thurnertristan/diplomarbeit_dateien/Mechanik/Gesamtprojekt Biegelehre/Biegelehre (Gesamtpr.)/20260723_121837 (1).jpg

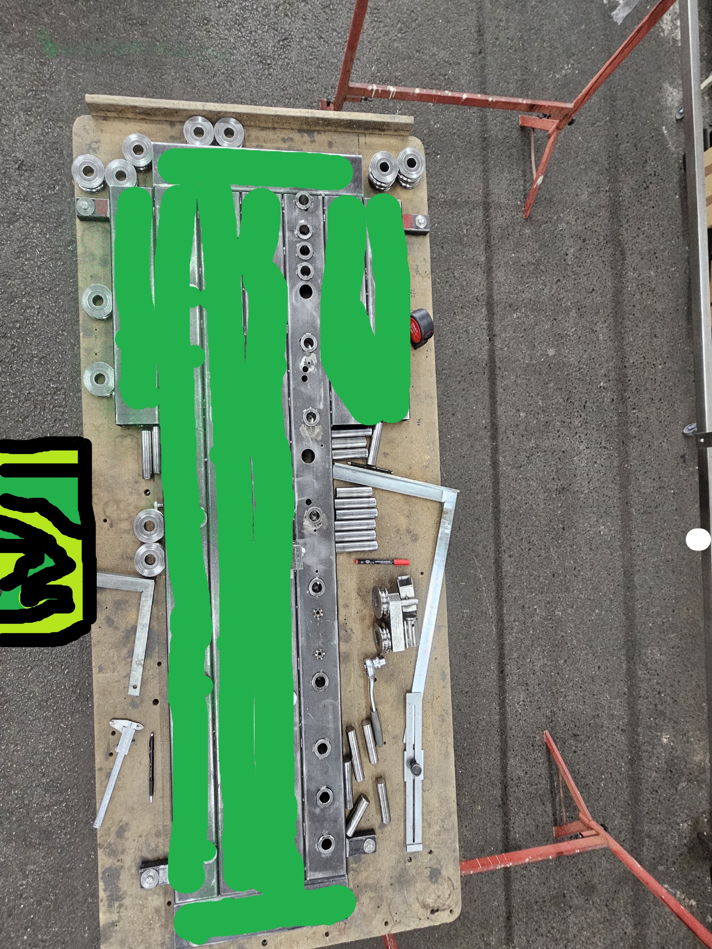
Mechanik/Gesamtprojekt Biegelehre/Biegelehre (Gesamtpr.)/20260723_121837 (1).jpg
