thurnertristan/diplomarbeit_dateien/Dokumentation Ferialpraktikum.docx

# Dokumentation Ferialpraktikum

## 1. Ausgangslage

Die Firma Dry Expert SMD fertigt Trocknungsanlagen, dafür brauchen sie 2D Gestelle aus Edelstahlrohre in verschiedenen Formen. Diese werden zurzeit händisch gebogen: Eine Person spannt Rohr ein, setzt Biegerollen an den passenden Positionen in einer Lochraster Biegelehre ein und biegt anschließend mit einer Verlängerung das Rohr um die Rollen. Dieser Prozess ist auf Dauer körperlich sehr anspruchsvoll und benötigt Erfahrung.

Ziel der Diplomarbeit ist die Automatisierung des Biegevorgangs mit einem an der Decke montierten Roboterarm. Der Roboterarm platziert die Rollen selbstständig auf der Biegelehre und führt danach mit einem selbst konstruierten Biegekopf die Biegung aus. Die gewünschte Form wird über einen Touchscreen ausgewählt. Es wurde sich bewusst für die Deckenmontage entschieden, da so der Arbeitsbereich kleiner ist und das Einlegen des Rohres weiterhin leicht möglich ist.

Das Rohr hat einen Außendurchmesser von 14mm, eine Wandstärke von 1mm und besteht aus Edelstahl 1.4404 (316).

## 2. Aufgabenteilung

Sebastian Benedikt: Auswahl elektrischer Bauteile, Verkabelung, Auslegung der Elektronik sowie Programmierung der Steuerung und des Roboterarms.

Tristan Thurner: Gehäuse für Elektronik, Sicherheitsbewertung, Biegekopf Konstruktion, Berechnungen für Auswahl sämtlicher mechanischen Komponenten

## 3. Technisches Gesamtkonzept

Das System besteht aus einem an der Decke montierten Fairino FR20 Roboterarm, der zwei Aufgaben in einem Arbeitszyklus übernimmt: Erstens das einsetzen der Stifte und Biegerollen in die Schablone, zweitens das eigentliche Biegen des Rohres mit einem eigens entwickelten, motorisierten Biegekopf (Servomotor & Planetengetriebe). Die Umschaltung zwischen den beiden Werkzeugen erfolgt über einen automatischen Werkzeugwechsler (ATC).

Durch den Biegekopf muss nicht der Fairino Cobot die ganze Kraft der Biegung aufwenden sondern muss nur noch die Haltekraft, da der Servomotor die Kraft aufwendet.

### Kinematik des Biegekopfs

Der Biegekopf dockt über eine Kugellagerbohrung auf den Bolzen der feststehenden Rolle an. Bildet den ortsfesten nicht rotierenden Drehpunkt, koaxial zur Antriebswelle. Ein Schwenkarm, der einen fest montierten zweiten Bolzen mit einer nadelgelagerten Rolle trägt, rotiert um diesen Drehpunkt und reproduziert damit exakt die Bewegung der Bisherigen manuellen Biegevorrichtung. Motor und Getriebe im Gehäuse des Biegekopfs bleiben ortsfest, nur die Antriebswelle treibt den Schwenkarm an. Das geschätzte Gesamtgewicht des Biegekopfs inkl. ATC liegen bei rund 17,5kg.

## 4. Auswahl und Auslegung der elektronischen Komponenten

Im Rahmen des Praktikums wurde eine komplette Elektronik-Stückliste (BOM) erarbeitet und dokumentiert. Alle zehn Kategorien – Antrieb, Recheneinheit, MCU, HMI, Werkzeugwechsler, Kommunikation, Sicherheitstechnik, Stromversorgung, Sensorik und Schaltschrank – sind mittlerweile weitestgehend final entscheiden. Die folgenden Tabellen fassen die wichtigsten Entscheidungen zusammen.

### Antriebsstrang

Komponente | Auswahl | Kernspezifikation | Preis (netto) | Status
Roboterarm | Fairino FR20 | 20 kg Traglast, 1854 mm Reichweite, ±0,1 mm, CE/ISO 10218 | 14.678,00 € | Final
Motor Biegekopf | Panasonic Minas A6 MSMF082L1U1 | 750 W, 2,39 Nm nominal / 7,16 Nm Spitze, 23-Bit-Encoder | 557,95 € | Final
Getriebe Biegekopf | APEX AB115-S2-P2, i=100 | ~225 Nm Dauermoment (nach Wirkungsgrad), gebraucht, 10–12 kg | 479,80 €* | Final (Fallback eBay)
Servoverstärker | Panasonic MCDLN35SE | B-Frame, 750 W, 230 VAC, passend zu MSMF082L1U1 | 1.223,04 € | Final

### Steuerung, HMI & Werkzeugwechsler

Komponente | Auswahl | Kernspezifikation | Preis (netto) | Status
Recheneinheit | Beelink Mini S12 Pro | Intel N100, 16 GB RAM, 500 GB SSD, Ubuntu 24.04 LTS + ROS2 Jazzy | 369,00 € | Final
MCU Biegekopf | STM32 Nucleo-F401RE | ARM Cortex-M4, lokale PWM-/Encoder-Ansteuerung im Biegekopf | ~20,00 € | Final
Touchscreen | Elecrow RC070 | 7" IPS, 1024×600, kapazitiv, USB + HDMI | ~53,00 € | Final
Werkzeugwechsler (ATC) | Schunk SWS-I/SWS-L + SWO-E | Elektromodul für RS485-Durchführung; SWK am Roboter, SWA je Werkzeug | 3.000–7.000 €* | Final (Angebot ausständig)

### Sicherheitstechnik und Stromversorgung

Komponente | Auswahl | Kernspezifikation | Preis (netto) | Status
Sicherheitslichtgitter | Pilz PSENopt | Typ 4 / PL e, Schutzfeldhöhe noch offen (Platzhalter 500 mm) | ~350,00 € | Final*
Sicherheitsrelais | Pilz PNOZ X1 | 24 V AC/DC, Kat. 4 / PL e, für Not-Aus + Lichtgitter | ~75,00 € | Final
Not-Aus-Taster | Pilz PIT es Set1s-5 | 2 Öffner, IP65, mechanische Entriegelung | ~60,00 € | Final
24V-Netzteil | Mean Well NDR-240-24 | 24 V DC, 240 W, 10 A, Hutschienenmontage | ~80,00 € | Final
DC-DC-Wandler | Mean Well SD-25B-12 | 24 V → 12 V, versorgt Mini-PC; wird vom Not-Aus mit abgeschaltet | ~35,00 € | Final

### Kommunikation, Sensorik und Gehäuse

Komponente | Auswahl | Kernspezifikation | Preis (netto) | Status
RS485-Modul (STM32-Seite) | MAX485 TTL-zu-RS485 | Im Biegekopf, Anschluss über Schraubklemmen A/B/GND | ~8,00 € | Final
USB-RS485-Konverter (PC-Seite) | Delock 62501 | 3 kV galvanisch isoliert, DIN-Schienenmontage | ~38,00 € | Final
Näherungssensor Werkzeugwechsel | Schunk IN-Serie (z. B. IN 40/S-M8) | 24 V DC, induktiv, Rückmeldung „Kopf angedockt“ | ~70,00 € | Final
Schaltschrank | Stahlblech-Wandgehäuse 800×600×300 | IP66, Leistungs-/Steuerzone nach EN 60204-1 getrennt | ~180,00 € | Final*

## 5. Softwareentwicklung (ROS2 – Workspace)

Parallel zur elektrischen Auslegung wurde bereits mit der Softwareentwicklung begonnen, um Zeit bis zum Eintreffen der Roboterhardware sinnvoll zu nutzen. Bereits programmiert wurde die Grundstruktur des Projekts. Außerdem wurde eine erste Simulation in Gazebo programmiert welche man mit einer GUI steuern kann welche wir mit Pygubu designed haben. Es wurden schon erste Testprogramme programmiert bei denen der Roboterarm bestimmte Punkte anfahren kann. Jedoch können wir die eigentlichen Programme erst richtig realisieren wenn wir die Hardware bekommen. Jedes Programm ist eigentlich nur eine JSON Datei in der die Punkte definiert werden und ein Python Programm rechnet sich dann die Bewegungen aus. Somit kann man neue Programme leicht erstellen und braucht nur einmal die Grundstruktur.

## 6. Mechanische Konstruktion

Es wurde bereits die erste Version des Biegekopfs konstruiert dieser beinhaltet das Gehäuse des Motors und Getriebe, Deckel mit flansch für ATC, der Verlängerung am Getriebe mit Kugellager und Stift. Außerdem wurde die Deckenkonstruktion konstruiert wo der Roboterarm in weiterer folge befestigt wird.

## 7. Nächste Schritte

- Berechnung aller relevanten Daten für den Biegekopf, Deckenmontage usw.
- Bestellung aller Teile und Fertigung des Biegekopfes
- Programmierung erweitern und verbessern
- Sicherheitskonzept ausarbeiten und finalisieren
