thurnertristan/diplomarbeit_dateien/Arbeitszusammenfassung.docx

# Arbeitszusammenfassung:

3.8.: schwächerer Cobot z.B. ur10 Biegung mit modularen Drehkopf Endeffektor mit eigenem Motor damit Roboterarm nicht Kraft aufwenden muss sondern nur halten und eigener Motor biegt. Mit Servomotor Planetengetriebe und Kupplung. Aufbau eigentlich gleich wie jetzt gerade nur nicht händisch drehen sondern mit dem Drehkopf.
