thurnertristan/diplomarbeit_dateien/Elektronik/Verkabelungskonzept_Rohrbiegesystem.docx

Diplomarbeit · Automatisiertes Rohrbiegesystem

Verkabelungskonzept – Elektronik

Stand: 19.08.2026 · Sebastian Benedikt / Tristan Thurner · für Dry Expert SMD GmbH

# 1. Überblick

Das Verkabelungskonzept beschreibt, wie Steuerung, Antrieb, Kommunikation und Sicherheitstechnik des Rohrbiegesystems miteinander verdrahtet werden. Die Elektronik ist auf einen zentralen Schaltschrank, den deckenmontierten Roboterarm (Fairino FR20) und den wechselbaren Biegekopf verteilt. Kernpunkt ist der Kabelweg vom Schaltschrank über den Roboterarm bis zum Motor im Biegekopf – dieser muss den automatischen Werkzeugwechsel (ATC) durchqueren, ohne dass beim Wechseln Kabel getrennt oder gesteckt werden müssen.

Der Schaltschrank gliedert sich nach EN 60204-1 in eine Steuerzone (Kleinspannung, Kommunikation) und eine Leistungszone (230 V AC, Servoantrieb), dazu kommt eine separate Sicherheitskette (Not-Aus, Lichtgitter, Sicherheitsrelais). Alle drei Zonen sind im Schaltschrank räumlich getrennt untergebracht.

# 2. Schaltschrank – Steuerzone

In der Steuerzone sitzen alle kleinspannungsseitigen Komponenten der Recheneinheit und Kommunikation:

- Mini-PC Beelink Mini S12 Pro – Recheneinheit für ROS2/MoveIt2, PANATERM und die Bedien-GUI
- Touchscreen Elecrow RC070 (7") – an den Mini-PC über HDMI + USB angebunden, sitzt auf der Schranktür
- DC-DC-Wandler Mean Well SD-25B-12 – wandelt 24 V DC auf 12 V DC für die Stromversorgung des Mini-PCs; dadurch schaltet der zentrale Not-Aus auch den PC mit ab
- USB-RS485-Konverter Delock 62501 – galvanisch isoliert (3 kV), verbindet den Mini-PC per internem USB mit dem RS485-Bus

Die galvanische Isolierung des RS485-Konverters ist notwendig, weil die RS485-Leitung im weiteren Verlauf direkt neben dem Servoverstärker liegt, der mit bis zu 22 A und steilen PWM-Flanken schaltet. Ohne Trennung könnten Störungen bis zum USB-Port des Mini-PCs durchschlagen.

# 3. Schaltschrank – Leistungszone

Die Leistungszone enthält die 230-V- und 24-V-Versorgung sowie den Servoantrieb:

- 24V-Netzteil Mean Well NDR-240-24 (240 W, 10 A, Hutschiene) – zentrale Kleinspannungsversorgung für STM32, RS485-Modul, Sicherheitsrelais und DC-DC-Wandler
- LS-Schalter 10 A + 230-VAC-Zuleitung – Netzeinspeisung für den Servoverstärker
- Servoverstärker Panasonic MCDLN35SG – erhält 230 V AC Leistungseinspeisung sowie den Freigabekontakt aus der Sicherheitskette; kommuniziert per Modbus-RTU über RS485

Der Servoverstärker bleibt fest im Schaltschrank montiert – nur der Motor sitzt im wechselbaren Biegekopf. Das ist bewusst so gewählt, damit beim Werkzeugwechsel kein Leistungsteil mitbewegt werden muss.

# 4. Sicherheitskette

Die Sicherheitskette ist als eigener, elektrisch unabhängiger Strang nach Kategorie 4 / PL e aufgebaut:

- Sicherheitslichtgitter Pilz PSENopt (Typ 4, PL e) → OSSD-Sicherheitssignal an das Sicherheitsrelais
- Not-Aus-Taster Pilz PIT es Set1s-5 → 2 Öffner-Kontakte an das Sicherheitsrelais
- Sicherheitsrelais Pilz PNOZ X1 (24 V AC/DC, Kat. 4 / PL e) → gibt bei „alles frei" den Freigabekontakt für die Motorleistung am Servoverstärker frei

Lichtgitter und Not-Aus-Taster wirken damit gemeinsam auf denselben Freigabepfad: Erst wenn beide Bedingungen erfüllt sind, schaltet das PNOZ X1 den Servoverstärker frei. Die Schutzfeldhöhe des Lichtgitters ist aktuell ein Platzhalter (500 mm) und wird nach der ISO-12100-Beurteilung final festgelegt.

# 5. Kabelweg durch den Werkzeugwechsler (ATC)

Der automatische Werkzeugwechsler (Schunk SWS-I/SWS-L mit SWO-E-Elektromodul) ist die kritischste Stelle im Verkabelungskonzept, weil hier Leistungs- und Signalkabel ohne manuellen Steckvorgang durchgeführt werden müssen.

- Vom Schaltschrank laufen Motorkabel (U/V/W + Encoder) und die isolierte RS485-Leitung über eine Kabelführung am Roboterarm zur roboterseitigen ATC-Hälfte (SWK).
- Die SWO-E-Durchführung überträgt die Signale per federbelasteten, goldbeschichteten Kontaktstiften automatisch beim mechanischen Andocken – kein separater Steckvorgang nötig.
- Werkzeugseitig (SWA) werden die Leitungen wieder aufgeteilt und laufen kurz weiter zu Motor, RS485-Modul (MAX485) und STM32 im Biegekopf.
- Zusätzlich liefert die Kolbenhubabfrage-Option am SWK mit einem Schunk-eigenen Näherungssensor das digitale 24-V-Signal „Kopf angedockt" zurück an den STM32.

Offen ist noch, ob ein gemischtes SWO-E-Modul (Signal + Leistung) für die 22-A-Motorphasen ausreicht oder ob Schunk getrennte Module für Signal und Leistung vorschreibt. Beide Varianten würden aber an derselben SWK/SWA-Kupplungsstelle sitzen – es entsteht keine zweite ATC-Schnittstelle.

# 6. Motor-, Encoder- und Batteriekabel

Für die Strecke Schaltschrank → Roboterarm → ATC → Biegekopf wurden die Original-Panasonic-Kabel in 10 m Länge gewählt (Motorkabel MFMCA0100NJD, Encoderkabel MFECA0100MJE):

- Die Kabel sind werksseitig mit Steckern an beiden Enden konfektioniert und müssen daher in der Mitte durchtrennt werden, um durch die ATC-Trennstelle geführt zu werden.
- Beide neu geschnittenen Enden erhalten je einen Steckverbinder auf SWK bzw. SWA – die Original-Werksstecker bleiben an den jeweiligen Kabelenden erhalten.
- Kritisch: Die Encoder-Batteriebox (DV0P2990) für die Multiturn-Absolutfunktion muss auf der motorseitigen Kabelhälfte sitzen. Sonst verliert der Encoder bei jedem Werkzeugwechsel seine Absolutposition, weil die Batterieverbindung beim Abkoppeln unterbrochen wird.
- Der Anschluss am Servoverstärker (MCDLN35SG) erfolgt über die Panasonic-Steckverbinder DV0PM20032 (XA, Netzanschluss) und DV0PM20034 (XB, Motoranschluss) – der Verstärker selbst hat keine festen Klemmen.

Das eigentliche Zuschneiden der Kabel erfolgt erst, sobald das Schunk-Angebot mit der finalen RS485-Pinbelegung und Kontakt-Terminierungsart vorliegt.

# 7. Kommunikationskette (RS485)

Die Ansteuerung von Servoverstärker und STM32 läuft über eine gemeinsame, durchgeschleifte RS485-Leitung:

- Mini-PC → Delock 62501 (isolierter USB-RS485-Konverter) → RS485 A/B/GND durch die SWO-E-Durchführung → MAX485-Modul im Biegekopf → STM32 Nucleo-F401RE
- Der STM32 steuert darüber hinaus den Servoverstärker direkt über ein Pulszug-/Step-Dir-Signal, das ebenfalls durch die ATC-Durchführung geführt wird.
- Die RS485-Pinbelegung ist noch eine vorläufige Annahme und wird gegen das konkrete Schunk-SWO-E-Angebot verifiziert (siehe „RS485_Leitungsplanung_SWO-E.docx").

# 8. Robotersteuerung

Die FR20-Robotersteuerung (Controller-Box) ist als separate Einheit vom Mini-PC über Ethernet (TCP/IP) angebunden und steuert von dort aus die sechs Achsen (J1–J6) des Roboterarms. Diese Schnittstelle ist bislang softwareseitig noch nicht endgültig geprüft und bleibt ein offener Punkt. Die Maße der FR20-Controller-Box müssen zudem bei Inlux Robotics angefragt werden, um zu klären, ob sie in den geplanten Schaltschrank passt.

# 9. Energiekette am Roboterarm

Für die flexible Kabelführung entlang der Roboterarm-Bewegung ist eine 3D-Zugkette speziell für die FR20 vorgesehen (3 m Länge, 37 mm Innenkanal, 4 Schraubhalterungen für die vorhandenen Befestigungslöcher am Arm, seitlich zu öffnen), erhältlich bei TMC Robotics. Eine interne Kabeldurchführung durch die FR20 selbst gibt es nicht – die Kabelführung verläuft komplett extern am Arm entlang, wie bei diesem Robotermodell üblich.

# 10. Übersichtstabelle Hauptverbindungen

Von | Nach | Leitung / Signal
Mini-PC | Touchscreen | HDMI + USB
Mini-PC | USB-RS485-Konverter | USB (intern, Host)
24V-Netzteil | DC-DC-Wandler → Mini-PC | 24 V DC → 12 V DC, Hohlstecker
24V-Netzteil | Sicherheitsrelais / ATC / STM32 | 24 V DC Versorgung
LS-Schalter | Servoverstärker | 230 V AC Leistungseinspeisung
Lichtgitter | Sicherheitsrelais | OSSD-Sicherheitssignal
Not-Aus-Taster | Sicherheitsrelais | 2× Öffner-Kontakt
Sicherheitsrelais | Servoverstärker | Freigabekontakt (Motorleistung)
USB-RS485-Konverter | ATC-Durchführung | RS485 A/B/GND, isoliert 3 kV
Servoverstärker | ATC-Durchführung | Motorkabel: U/V/W + Encoder
ATC-Durchführung | Motor (Biegekopf) | Motorkabel: U/V/W + Encoder
ATC-Durchführung | RS485-Modul (MAX485) | RS485 durchgeschleift
RS485-Modul | STM32 | UART (TTL)
STM32 | Servoverstärker | Pulszug/Step-Dir-Signal (durch ATC)
Näherungssensor | STM32 | digitales 24-V-Signal (Kopf angedockt)
Mini-PC | FR20-Robotersteuerung | Ethernet TCP/IP (offener Punkt)
FR20-Robotersteuerung | Roboterarm FR20 | Motion-Steuerung (Achsen J1–J6)

# 11. Offene Punkte

- RS485-Pinbelegung gegen das tatsächliche Schunk-SWO-E-Angebot prüfen.
- Klärung 1-vs-2-Module-Frage bei SWO-E: gemischtes Signal/Leistungs-Modul oder getrennte Module?
- Sicherungsdimensionierung der Servoverstärker-Zuleitung von einer Elektrofachkraft prüfen lassen.
- Ethernet-Anbindung Mini-PC ↔ FR20-Robotersteuerung softwareseitig verifizieren.
- 10-m-Kabel erst nach Vorliegen des Schunk-Angebots in der Mitte trennen und auf SWK/SWA terminieren (Batteriebox motorseitig).
- Maße der FR20-Robotersteuerung bei Inlux Robotics anfragen (Platzbedarf im Schaltschrank).
- Schutzfeldhöhe des Lichtgitters nach Tristans ISO-12100-Beurteilung final festlegen.

Quelle: Projekt-Dashboard „rohrbiegesystem_dashboard.html" und Verkabelungsdiagramm „Elektronik_Verkabelung_Rohrbiegesystem.drawio", Stand 19.08.2026.
