thurnertristan/diplomarbeit_dateien/Roboterauswahl/Roboterauswahl.docx

Roboterauswahl

Cobots:

Hersteller | Modell | Traglast | Preis | Link
DOOSAN | H2017 | 20kg | 20.400€ | https://www.maschinensucher.at/doosan-h2017/i-20891532
Universal Robots | UR10 | 10kg | 15.500€ | https://www.maschinensucher.at/cobot+universal+robots-ur10+cb3.1/i-22373017

Industrieroboter

Hersteller | Modell | Traglast | Preis | Link
KUKA | KR16 | 16kg | Auf Anfrage | https://www.maschinensucher.at/kuka-kr+16/i-22401477
KUKA | KR16 | 16kg | 8.500€ | https://www.maschinensucher.at/kuka-kr+16+l6-c/i-18950501
ABB | IRB4600-20/2.50 | 20kg | 11.500€ | https://www.maschinensucher.de/abb-irb4600-20%2F2.50/i-20652730
