thurnertristan/diplomarbeit_dateien/Servoverstaerker_Antriebsstrang_BOM.xlsx

Einkaufsliste: Servoverstärker-Antriebsstrang
# | Teil | Teilenummer | Zweck | Preis | Lieferzeit | Bezugsquelle | Link
1 | Servoverstärker | MCDLN35SG | Motoransteuerung (RS485/Modbus + Pulszug) | 829,54 € netto | Sofort (2 Stk. auf Lager) | DigiKey | https://www.digikey.at/en/products/detail/panasonic-industrial-automation-sales/MCDLN35SG/7354308
2 | Encoderkabel (Original) | MFECA0100MJE | 10m, Driver↔Motor Encoder (23-Bit Absolut) | 614,74 € netto | 1 Stk. auf Lager – bei Nachbestellung 36 Wochen | DigiKey | https://www.digikey.at/en/products/detail/panasonic-industry/MFECA0100MJE/3898448
3 | Motorkabel (Original) | MFMCA0100NJD | 10m, Driver↔Motor Leistung (U/V/W) | 539,26 € netto | 1 Stk. auf Lager – bei Nachbestellung 36 Wochen | DigiKey | https://www.digikey.at/en/products/detail/panasonic-industry/MFMCA0100NJD/3898493
4 | Netzanschluss-Stecker (XA) | DV0PM20032 | Steckverbinder für Netzzuleitung zum Driver | 37,07 € netto | ca. 4 Wochen | electricautomationnetwork.com | https://www.electricautomationnetwork.com/en/panasonic/dv0pm20032-panasonic-minas-a5-driver-power-connector-xa-50w-to-15kw-1-row
5 | Motorstecker (XB) | DV0PM20034 | Steckverbinder für Motorkabel am Driver, inkl. Jumper-Kabel | 37,07 € netto | ca. 4 Wochen | electricautomationnetwork.com | https://www.electricautomationnetwork.com/en/panasonic/dv0pm20034-panasonic-connector-for-minas-a5-driver-motor-connection-xb-50w-15kw-spring-force-plug-spare
Summe (netto): |  |  |  | 2.057,68 € netto
