thurnertristan/diplomarbeit_dateien/Bestellliste_aktuelle_Runde_kompakt_4.xlsx

Bestellliste – Aktuelle Runde
Stand 21.08.2026 · Preise vor Bestellung erneut bestätigen
Komponente | Anbieter | Preis (EUR) | Link
Beelink Mini S12 Pro (Intel N100, 16 GB RAM, 500 GB SSD) | Amazon.de | 362.02 | https://www.amazon.de/Beelink-MINI-S12-Alder-Lake-N100-Processor/dp/B0B7WCTXMT
Elecrow DIS85101D, 10.1" IPS 1280x800, kapazitiver Touch, Acrylgehäuse | Elecrow (Direktshop, China) | 77.00 | https://www.elecrow.com/elecrow-10-1-inch-display-ips-1280x800-acrylic-case-touch-screen-compatible.html
Waveshare USB TO RS485/422, Industrial Grade Isolated Converter | Amazon.de | 30.24 | https://www.amazon.de/Waveshare-USB-RS485-422-Long-Distance/dp/B0BTBR71PC
Mean Well NDR-240-24 | DigiKey AT/DE | 47.39 | https://www.digikey.de/de/products/detail/mean-well-usa-inc/NDR-240-24/7705222
Mean Well SD-25B-12, geschlossene Bauform | DigiKey AT/DE | 22.29 | https://www.digikey.de/de/products/detail/mean-well-usa-inc/SD-25B-12/7706509
Panasonic DV0PM20024CAB020 (X2-Steckverbinder für Verstärker, RS485/RS232) | electricautomationnetwork.com | 49.16 | https://electricautomationnetwork.com/en/panasonic/dv0pm20024cab020-panasonic-communication-cable-rs232-rs485-for-minas-a5-x2-connector-8-pins-and-loose-threads
Summe |  | 588.10
