thurnertristan/diplomarbeit_dateien/Mechanik/Biegekopf/Gehaeuse_gesamt/Anzahl.xlsx

Bauteil Name | Anzahl
geheause_motor | 1
gehaeuse_getriebe | 1
BT022_thutrn22_26_Biegeroboter_gehaeuse_deckel_motor_v3 | 1
BT025_thutrn22_26_Biegeroboter_gehaeuse_deckel_getriebe | 1
BT026_thutrn22_26_Biegeroboter_gehaeuse_getriebe_deckel_oben | 1
BT023_thutrn22_26_Biegeroboter_halterung_getriebe | 4
BT024_thutrn22_26_Biegeroboter_halterung_motor | 8
BT021_thutrn22_26_Biegeroboter_distanzleiste | 4
