thurnertristan/diplomarbeit_dateien/Mechanik/Adapter/SCHUNK-0302201 A-SWK-020-ISO-A50.stp

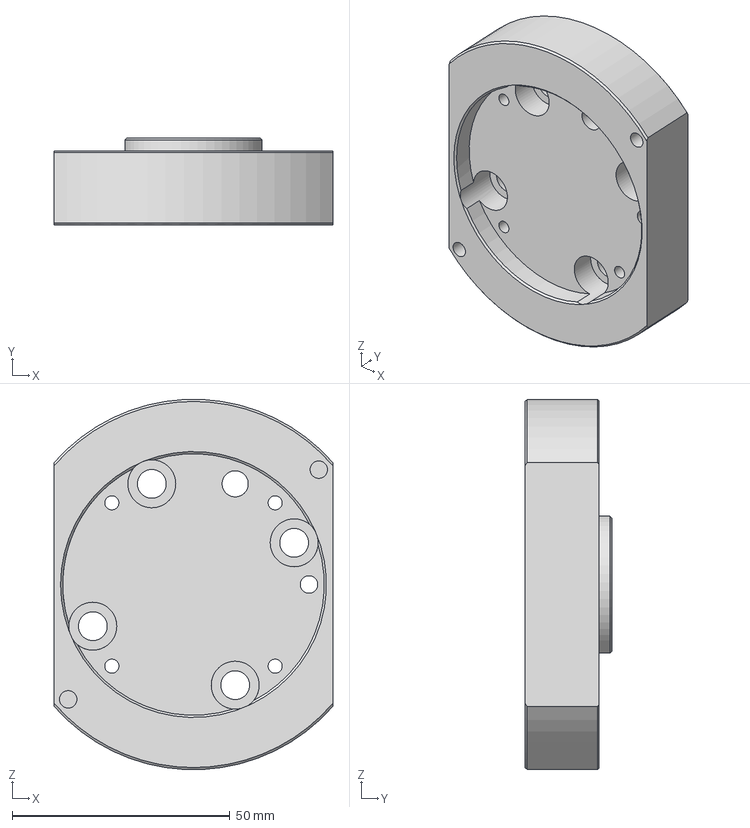
[picture p2: CAD file, 2026-08-13]
Mechanik/Adapter/SCHUNK-0302201 A-SWK-020-ISO-A50.stp
64.0 x 20.0 x 84.9 mm
