thurnertristan/diplomarbeit_dateien/Mechanik/Biegekopf/BG009_thutrn22_26_Biegeroboter_gehaeuse_gesamt_v3.stp

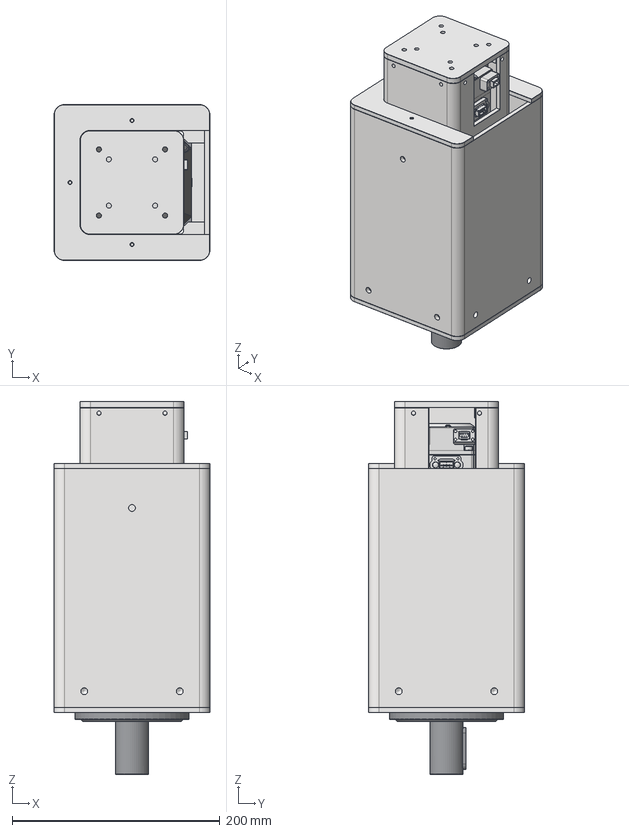
[picture p3: CAD file, 2026-10-08]
Mechanik/Biegekopf/BG009_thutrn22_26_Biegeroboter_gehaeuse_gesamt_v3.stp
150.0 x 150.0 x 359.0 mm
DIN EN 10219-2 - 100 x 100 x 5 - 130
DIN EN 10219-2 - 150 x 150 x 5 - 230
BT023_thutrn22_26 x 4
gearbox_ab115-100-s2-p2-12
BT024_thutrn22_26_Biegeroboter_halterung_motor x 8
BT021_thutrn22_26 x 3
MSME082G1U_msmf_gh
MSME082G1U_key
BT022_thutrn22_26
BT025_thutrn22_26
BT026_thutrn22_26
