thurnertristan/diplomarbeit_dateien/Mechanik/Biegekopf/Gehaeuse_gesamt/BT022_thutrn22_26_Biegeroboter_gehaeuse_deckel_motor_v3.stp

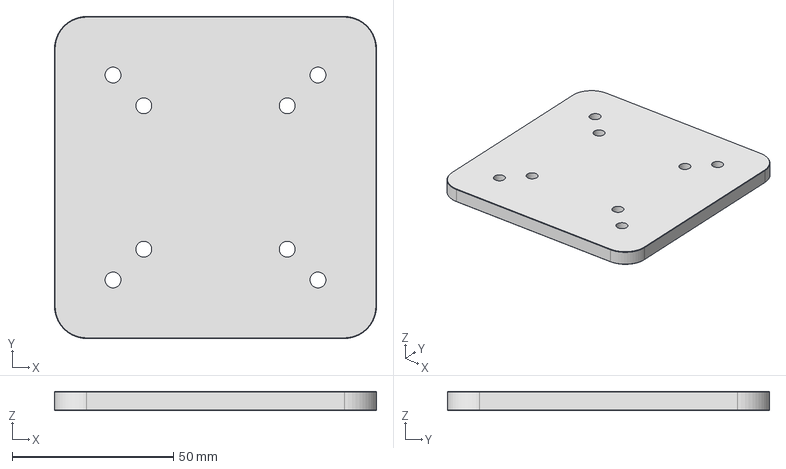
[picture p4: CAD file, 2026-10-08]
Mechanik/Biegekopf/Gehaeuse_gesamt/BT022_thutrn22_26_Biegeroboter_gehaeuse_deckel_motor_v3.stp
100.0 x 100.0 x 6.00 mm
