thurnertristan/diplomarbeit_dateien/Mechanik/Biegekopf/Gehäuse/Uebergangsdeckel_150_100_flach_abgerundet_stecker.step

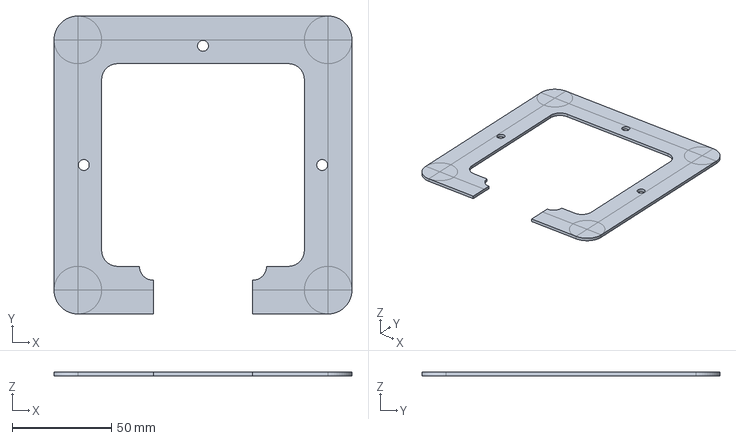
[picture p5: CAD file, 2026-10-08]
Mechanik/Biegekopf/Gehäuse/Uebergangsdeckel_150_100_flach_abgerundet_stecker.step
150.0 x 150.0 x 2.00 mm
