thurnertristan/diplomarbeit_dateien/Mechanik/Biegekopf/Verlängerung/BG003_thutrn22_26_Biegeroboter_verlängerung_gesamt_v2.stp

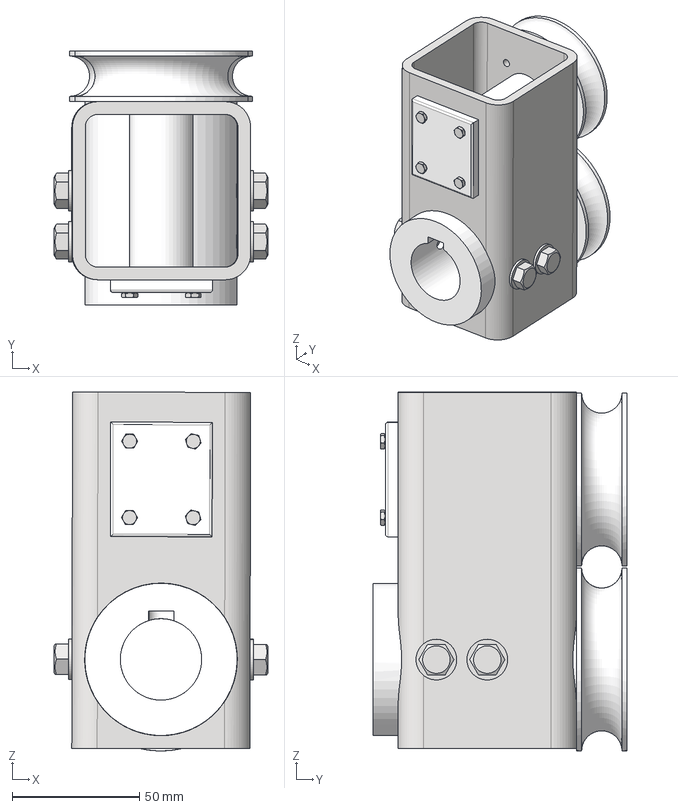
[picture p6: CAD file, 2026-10-08]
Mechanik/Biegekopf/Verlängerung/BG003_thutrn22_26_Biegeroboter_verlängerung_gesamt_v2.stp
84.0 x 100.0 x 141.1 mm
BT007_bensen22_26
BT009_bensen22_26
BT009_thutrn22_26
%3% BS 290 - SKF 6205
DIN 618 - HK2520 - 25 x 32 x 20
BT011_thutrn22_26
AS 1110 - M3 x 6 x 4
DIN EN 10219-2 - 70 x 70 x 5 - 120
AS 1427 - M8 x 16 x 4
