thurnertristan/diplomarbeit_dateien/Mechanik/Fairino FR20/Cobot_Stand.step

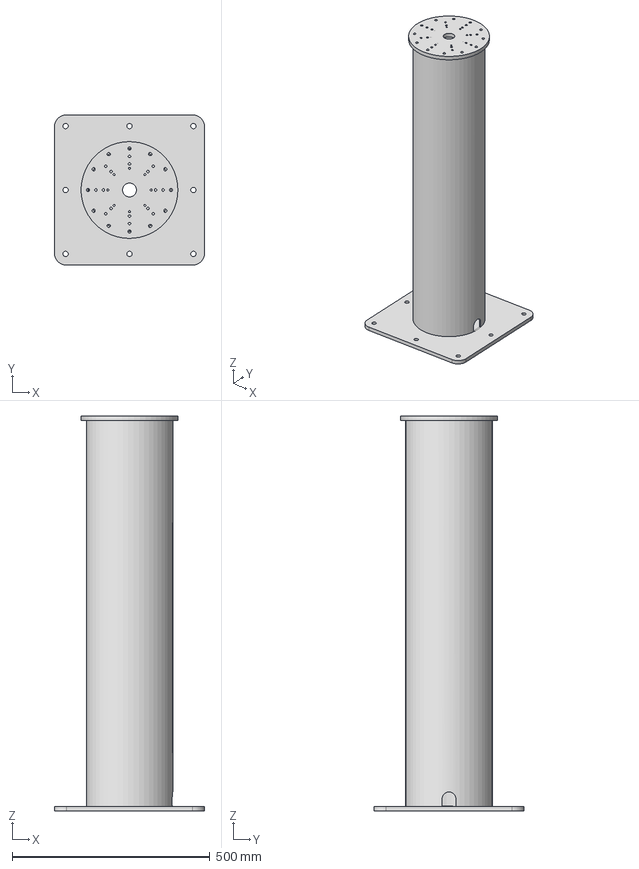
[picture p7: CAD file, 2026-08-13]
Mechanik/Fairino FR20/Cobot_Stand.step
380.0 x 380.0 x 1000.0 mm
