thurnertristan/diplomarbeit_dateien/Mechanik/Gehaeuse_Display/Monitoradapter_Elecrow_DIS85101D_auf_RAM_VESA75.step

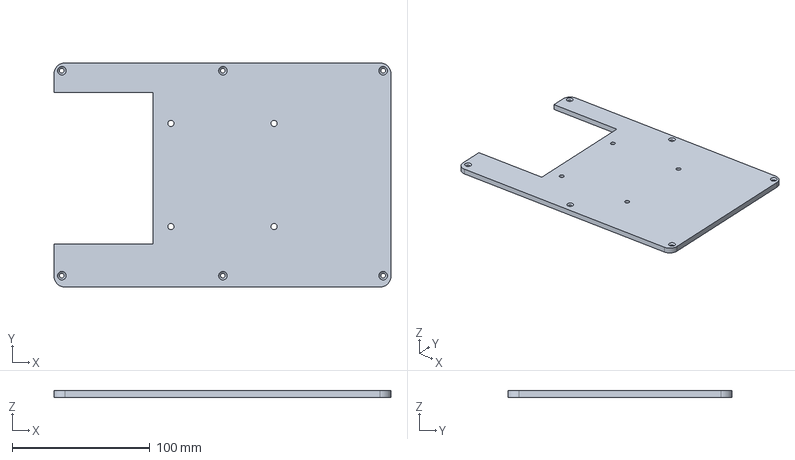
[picture p8: CAD file, 2026-10-08]
Mechanik/Gehaeuse_Display/Monitoradapter_Elecrow_DIS85101D_auf_RAM_VESA75.step
245.0 x 163.0 x 5.00 mm
