thurnertristan/diplomarbeit_dateien/Mechanik/Gesamtprojekt Biegelehre/Biegelehre.stp

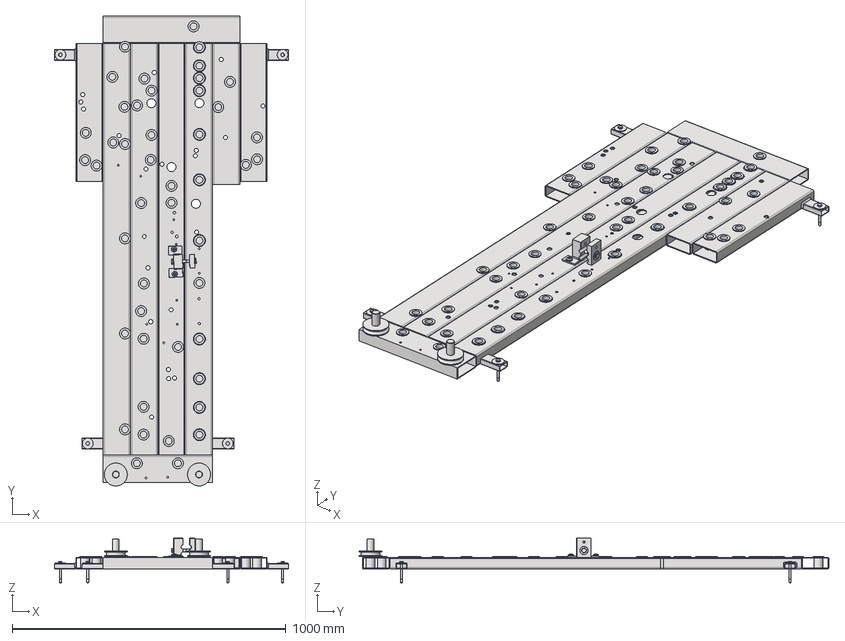
[picture p10: CAD file, 2026-08-13]
Mechanik/Gesamtprojekt Biegelehre/Biegelehre.stp
856.0 x 1718.4 x 163.0 mm
Biegelehre_1
Bauteil1
Buchse x 48
Einspannvorrichtung_1
Einspannvorrichtung Beilagscheibe
Einspannvorrichtung Nebenbacke
Einspannvorrichtung Hauptbacke
EInspannvorrichtung Befestigunsplatte x 2
Einspannvorrichtung Bolzenschraube
AS 1112 - M10 Typ 5
Anschweißlasche Schraube M8 x 4
Anschweißlasche_1 x 4
Anschweißlasche Scheibe x 4
Flachkopfschraube mit Innenrund ISO 14583 - M10 x 14 - 4.8 x 2
Biegerolle 66 x 2
Bolzen x 2
