thurnertristan/diplomarbeit_dateien/Mechanik/PARTserver0202608120914509970315710e898ce/SCHUNK-0302323 SWA-020-000-000_ .stp

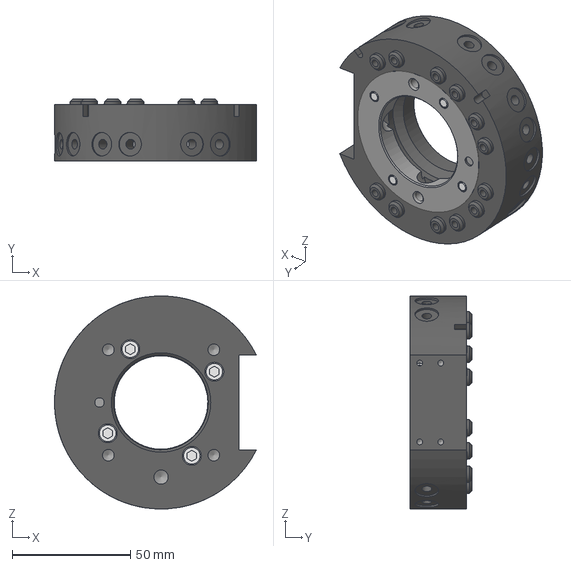
[picture p11: CAD file, 2026-08-13]
Mechanik/PARTserver0202608120914509970315710e898ce/SCHUNK-0302323 SWA-020-000-000_ .stp
85.3 x 26.0 x 89.9 mm
