thurnertristan/diplomarbeit_dateien/Mechanik/Biegekopf/Biegerolle 62.stp

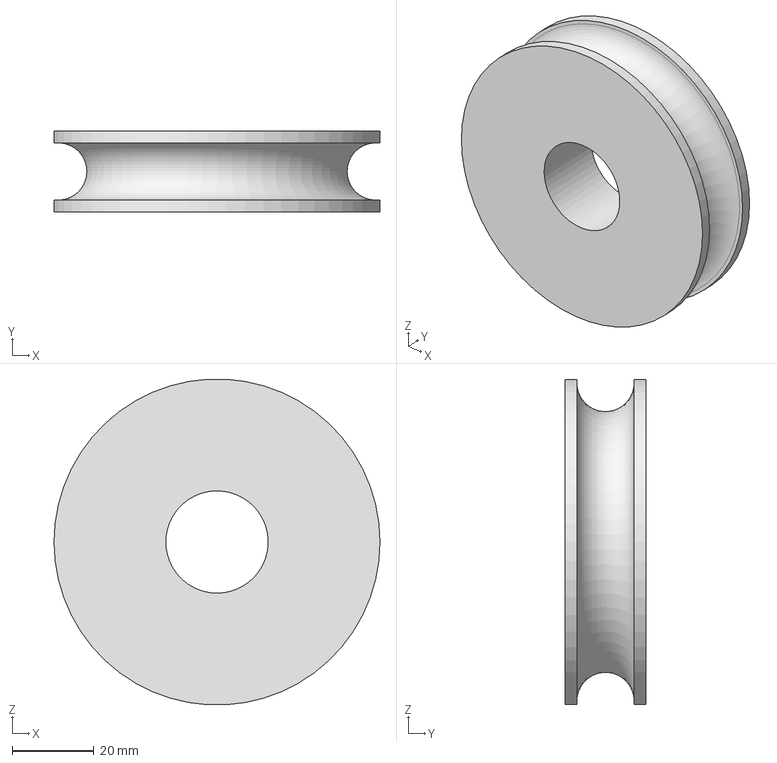
[picture p12: CAD file, 2026-08-11]
Mechanik/Biegekopf/Biegerolle 62.stp
80.0 x 20.0 x 79.9 mm
