thurnertristan/diplomarbeit_dateien/Mechanik/Biegekopf/Gehaeuse_gesamt/BT021_thutrn22_26_Biegeroboter_distanzleiste.stp

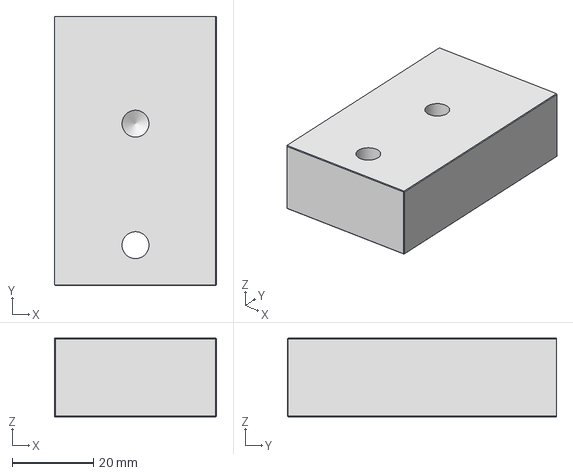
[picture p13: CAD file, 2026-10-08]
Mechanik/Biegekopf/Gehaeuse_gesamt/BT021_thutrn22_26_Biegeroboter_distanzleiste.stp
40.0 x 66.5 x 19.5 mm
