thurnertristan/diplomarbeit_dateien/Mechanik/Biegekopf/Gehäuse/gehaeuse_getriebe.stp

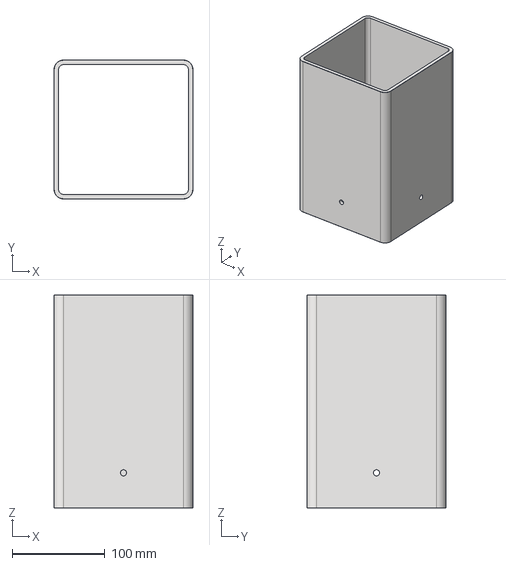
[picture p14: CAD file, 2026-10-08]
Mechanik/Biegekopf/Gehäuse/gehaeuse_getriebe.stp
150.0 x 150.0 x 230.0 mm
