thurnertristan/diplomarbeit_dateien/Mechanik/Fairino FR20/Fairino FR20.stp

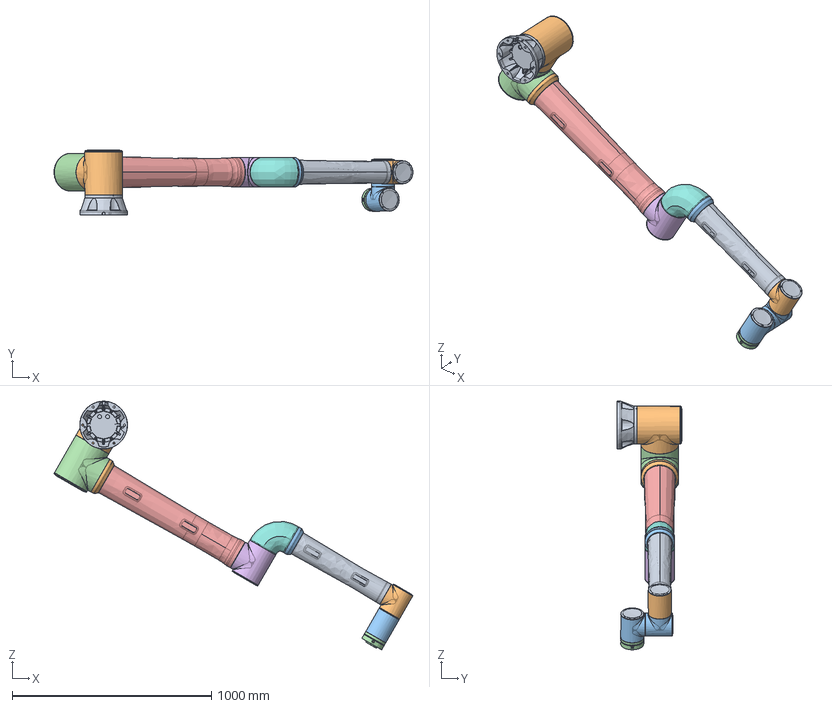
[picture p15: CAD file, 2026-08-13]
Mechanik/Fairino FR20/Fairino FR20.stp
1802.9 x 327.0 x 1248.7 mm
FR20-V6.0-1
FR20-V6.0-2
FR20-V6.0-3
FR20-V6.0-4
FR20-V6.0-5
FR20-V6.0-6
FR20-V6.0-7
FR20-V6.0-40¹Ø½Úºó¸Ç x 2
FR20-V6.0-32¹Ø½Úºó¸Ç
FR20-V6.0-25¹Ø½Úºó¸Ç x 3
FR20-V6.0-´ó±ÛÂÝË¿Õ Ö
FR20-V6.0-Ð¡±ÛÂÝË¿Õ Ö
