thurnertristan/diplomarbeit_dateien/Mechanik/Biegekopf/gearbox_ab115-100-s2-p2-12.step

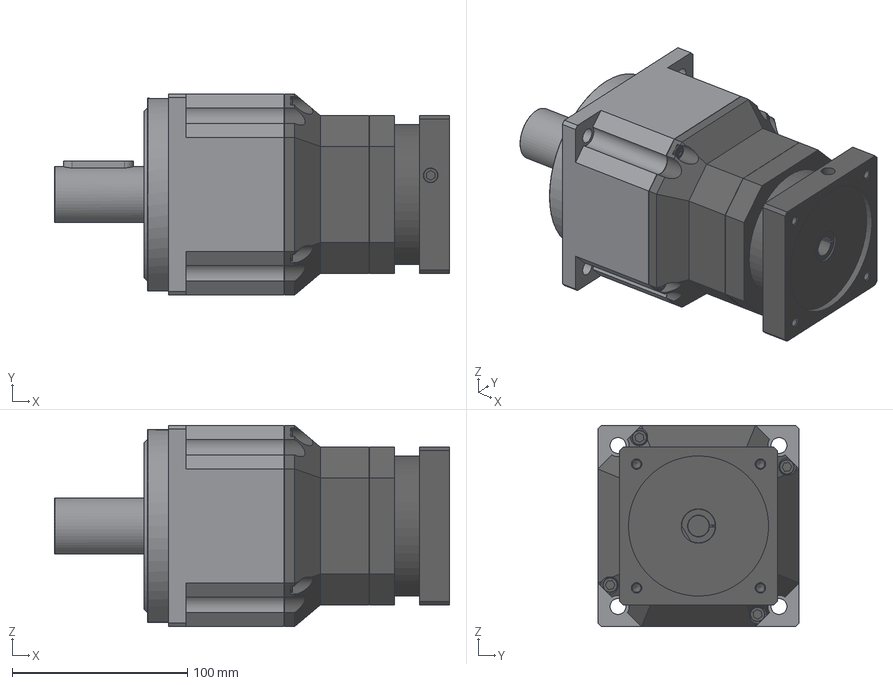
[picture p16: CAD file, 2026-08-11]
Mechanik/Biegekopf/gearbox_ab115-100-s2-p2-12.step
225.5 x 115.0 x 115.0 mm
