thurnertristan/diplomarbeit_dateien/Mechanik/Biegekopf/Gehaeuse_gesamt/BT024_thutrn22_26_Biegeroboter_halterung_motor.stp

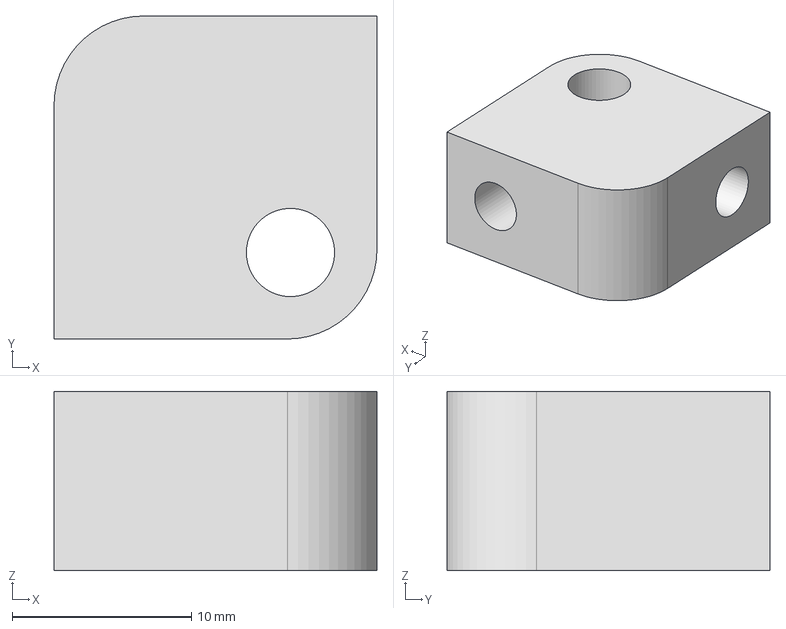
[picture p17: CAD file, 2026-10-08]
Mechanik/Biegekopf/Gehaeuse_gesamt/BT024_thutrn22_26_Biegeroboter_halterung_motor.stp
18.0 x 18.0 x 10.0 mm
