thurnertristan/diplomarbeit_dateien/Mechanik/Biegekopf/Gehäuse/BT029_auge_d40.dxf

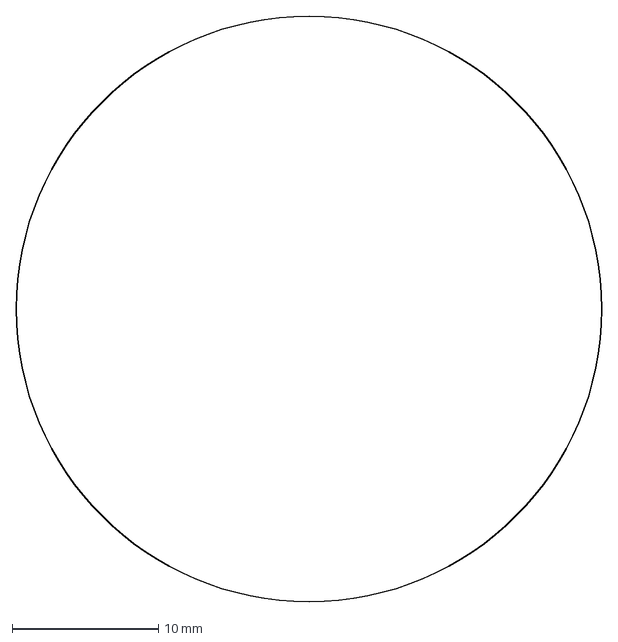
[picture p18: CAD file, 2026-10-08]
Mechanik/Biegekopf/Gehäuse/BT029_auge_d40.dxf
40.0 x 40.0 mm
