thurnertristan/diplomarbeit_dateien/Mechanik/Biegekopf/Bolzen.stp

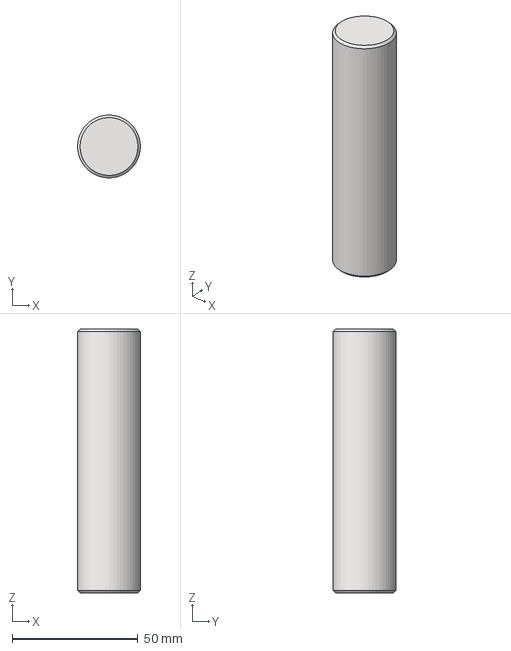
[picture p19: CAD file, 2026-08-11]
Mechanik/Biegekopf/Bolzen.stp
25.0 x 25.0 x 105.0 mm
