thurnertristan/diplomarbeit_dateien/Mechanik/Biegekopf/Gehäuse/gehaeuse_motor.stp

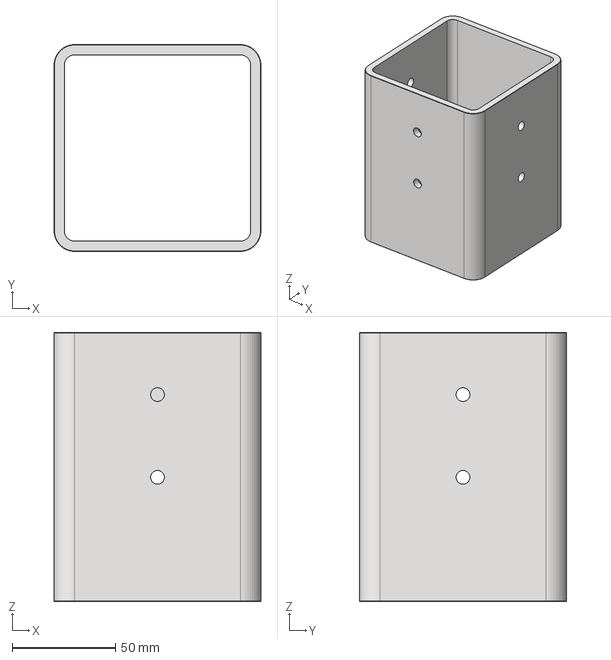
[picture p20: CAD file, 2026-10-08]
Mechanik/Biegekopf/Gehäuse/gehaeuse_motor.stp
100.0 x 100.0 x 130.0 mm
