thurnertristan/diplomarbeit_dateien/Mechanik/Biegekopf/Gehaeuse_gesamt/BT025_thutrn22_26_Biegeroboter_gehaeuse_deckel_getriebe.stp

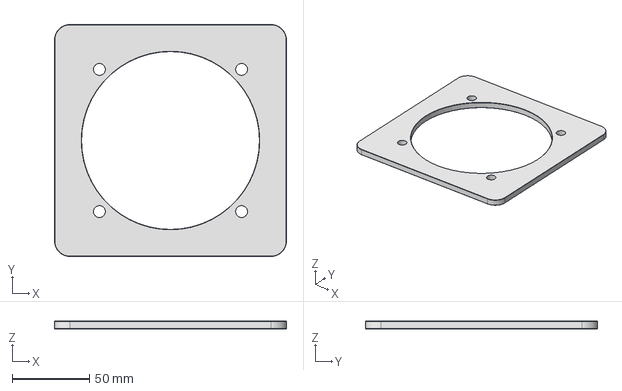
[picture p21: CAD file, 2026-10-08]
Mechanik/Biegekopf/Gehaeuse_gesamt/BT025_thutrn22_26_Biegeroboter_gehaeuse_deckel_getriebe.stp
150.0 x 150.0 x 5.00 mm
