thurnertristan/diplomarbeit_dateien/Mechanik/Biegekopf/Gehäuse/BT029_drehmomentstuetze_kontur.dxf

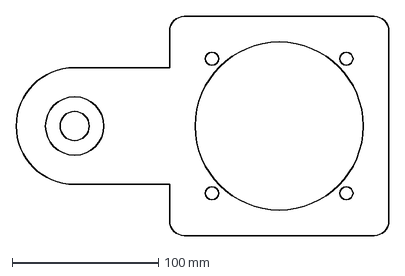
[picture p22: CAD file, 2026-10-08]
Mechanik/Biegekopf/Gehäuse/BT029_drehmomentstuetze_kontur.dxf
255.0 x 150.0 mm
