thurnertristan/diplomarbeit_dateien/Mechanik/Biegekopf/Biegerolle 66.stp

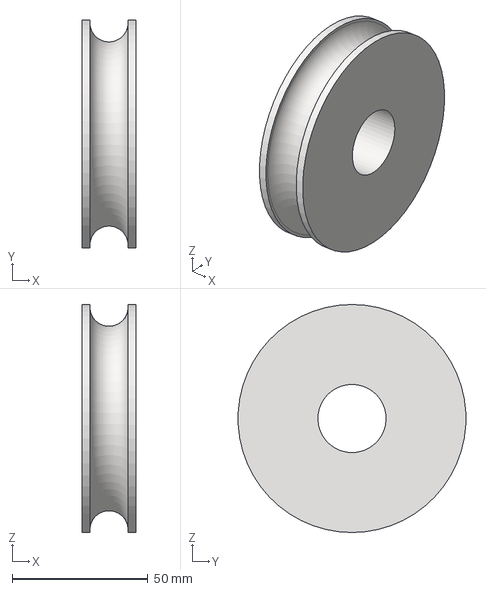
[picture p23: CAD file, 2026-08-11]
Mechanik/Biegekopf/Biegerolle 66.stp
20.0 x 83.9 x 84.0 mm
