thurnertristan/diplomarbeit_dateien/Mechanik/Biegekopf/Gehaeuse_gesamt/geheause_motor.stp

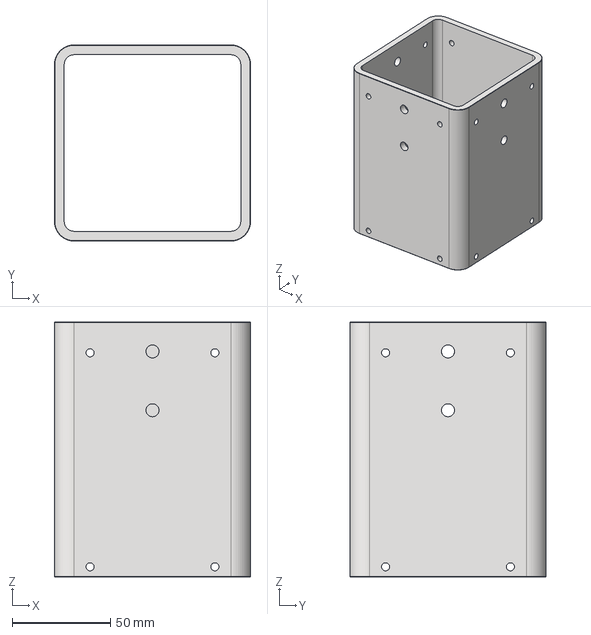
[picture p24: CAD file, 2026-10-08]
Mechanik/Biegekopf/Gehaeuse_gesamt/geheause_motor.stp
100.0 x 100.0 x 130.0 mm
