thurnertristan/diplomarbeit_dateien/Mechanik/Biegekopf/Gehäuse/Steuerungsgehaeuse_800x800x300_10Zoll.step

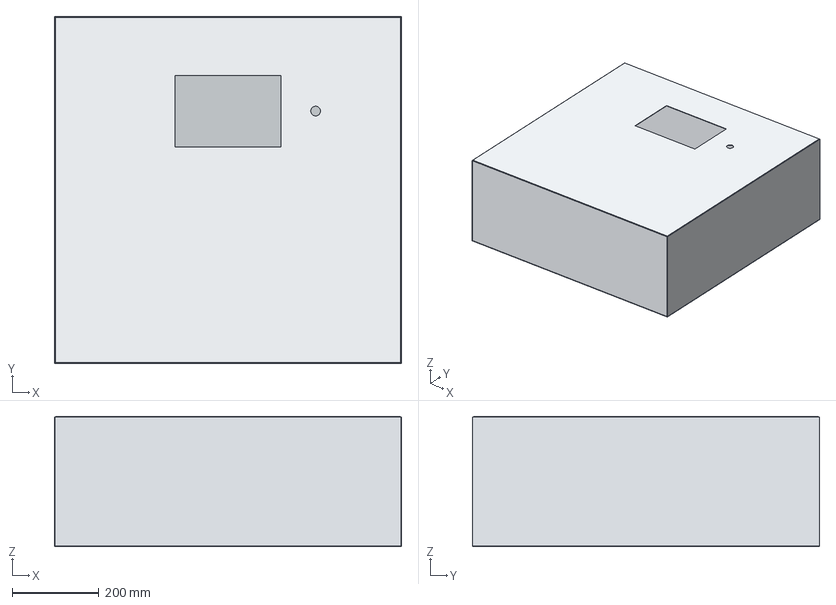
[picture p25: CAD file, 2026-10-08]
Mechanik/Biegekopf/Gehäuse/Steuerungsgehaeuse_800x800x300_10Zoll.step
800.0 x 800.0 x 300.0 mm
Rueckwand_800x800x1_5
Seitenwand_links
Seitenwand_rechts
Boden
Deckel
Montageplatte_700x700x2_5
Tuer_10Zoll_Ausschnitt_245x165
