thurnertristan/diplomarbeit_dateien/Mechanik/Biegekopf/Gehaeuse_gesamt/BT023_thutrn22_26_Biegeroboter_halterung_getriebe.stp

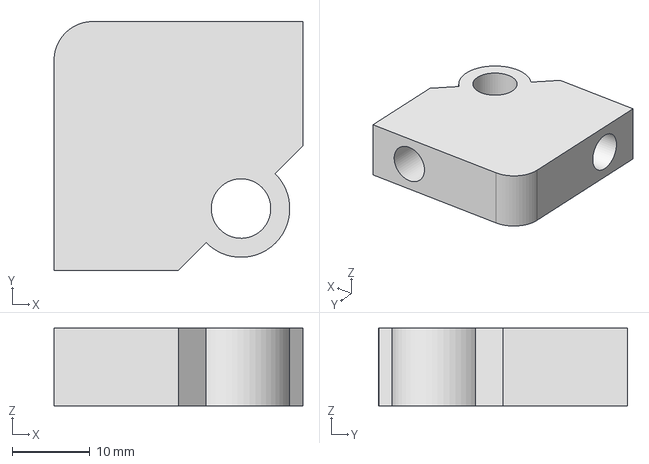
[picture p26: CAD file, 2026-10-08]
Mechanik/Biegekopf/Gehaeuse_gesamt/BT023_thutrn22_26_Biegeroboter_halterung_getriebe.stp
32.0 x 32.0 x 10.0 mm
