thurnertristan/diplomarbeit_dateien/Mechanik/Biegekopf/Gehäuse/Uebergangsdeckel_150_100_geteilt.step

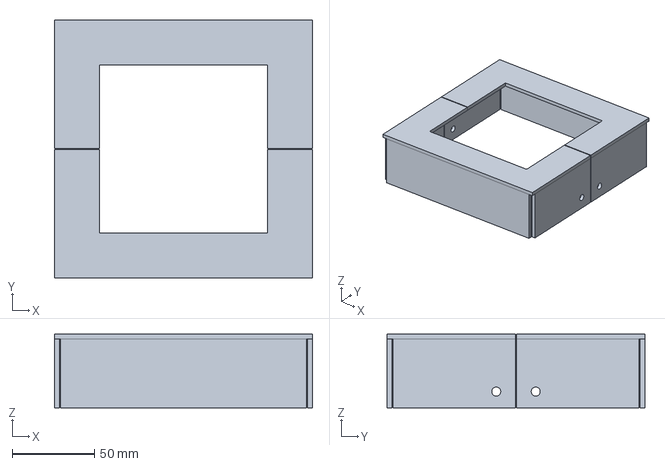
[picture p27: CAD file, 2026-10-08]
Mechanik/Biegekopf/Gehäuse/Uebergangsdeckel_150_100_geteilt.step
157.0 x 157.0 x 45.0 mm
