thurnertristan/diplomarbeit_dateien/Mechanik/Biegekopf/Hantelrolle.stp

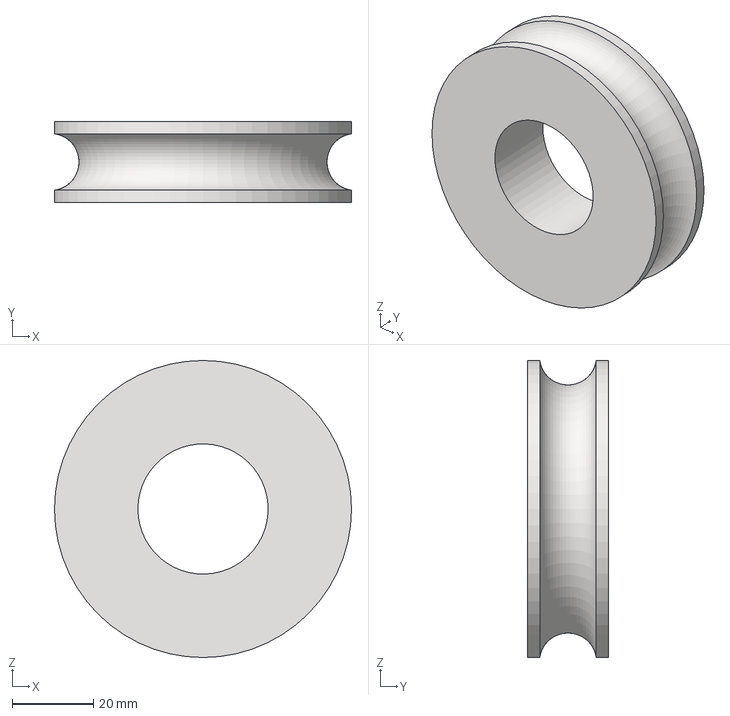
[picture p28: CAD file, 2026-08-11]
Mechanik/Biegekopf/Hantelrolle.stp
73.0 x 20.0 x 73.0 mm
