thurnertristan/diplomarbeit_dateien/Mechanik/Biegekopf/Gehaeuse_gesamt/BT026_thutrn22_26_Biegeroboter_gehaeuse_getriebe_deckel_oben.stp

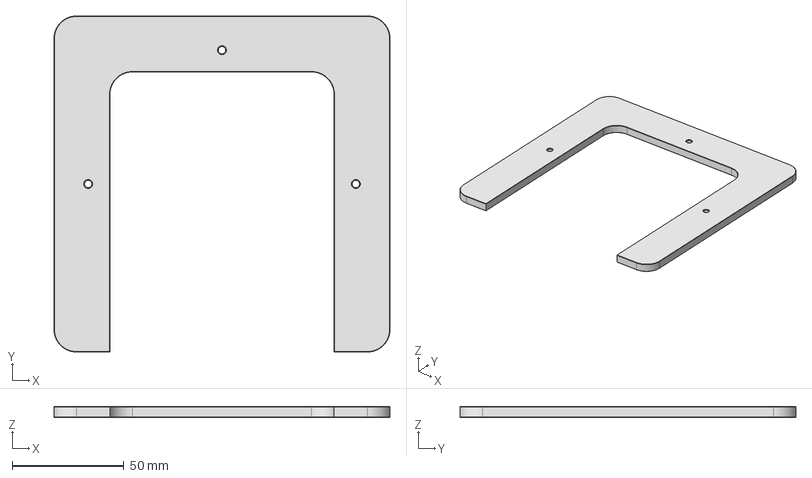
[picture p29: CAD file, 2026-10-08]
Mechanik/Biegekopf/Gehaeuse_gesamt/BT026_thutrn22_26_Biegeroboter_gehaeuse_getriebe_deckel_oben.stp
150.0 x 150.0 x 5.00 mm
