thurnertristan/diplomarbeit_dateien/Mechanik/Biegekopf/MSMF082L1U1.step

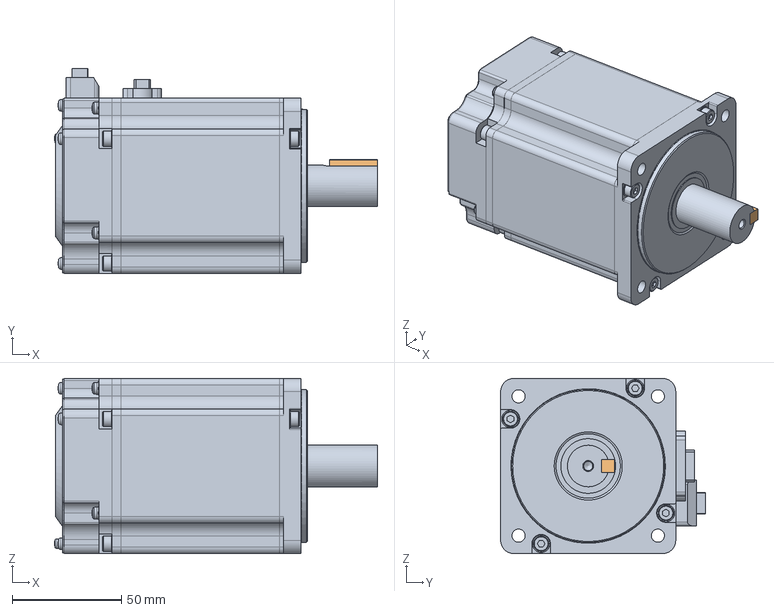
[picture p31: CAD file, 2026-08-11]
Mechanik/Biegekopf/MSMF082L1U1.step
147.6 x 93.5 x 80.0 mm
MSME082G1U_msmf_gh
MSME082G1U_key
