thurnertristan/diplomarbeit_dateien/Mechanik/Biegekopf/Gehäuse/BT029_bohrung_d20.dxf

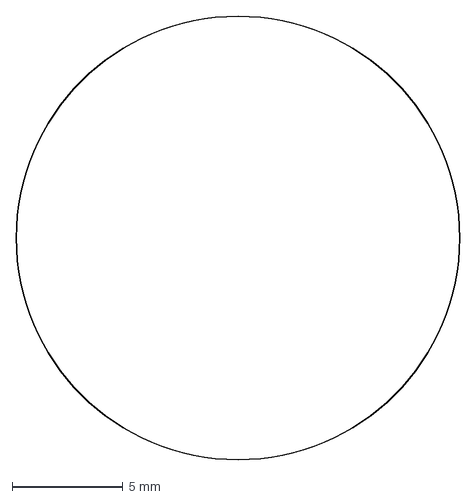
[picture p32: CAD file, 2026-10-08]
Mechanik/Biegekopf/Gehäuse/BT029_bohrung_d20.dxf
20.0 x 20.0 mm
