thurnertristan/diplomarbeit_dateien/(list of files, cad)

Other CAD files:
Mechanik/Biegekopf/Gehaeuse_gesamt/gehaeuse_getriebe.stp
Mechanik/Biegekopf/Fairino FR20.step
Mechanik/ATC/AIS2024/OldVersions/SCHUNK-0302322 SWK-020-000-000, .0002.iam
Mechanik/ATC/AIS2024/OldVersions/SCHUNK-SWK-020, 0.0001.ipt
Mechanik/ATC/AIS2024/SCHUNK-0302322 SWK-020-000-000, .iam
Mechanik/ATC/AIS2024/SCHUNK-SWK-020, 0.ipt
Mechanik/ATC_Kopfseite/AIS2024/OldVersions/SCHUNK-0302323 SWA-020-000-000, .0002.iam
Mechanik/ATC_Kopfseite/AIS2024/OldVersions/SCHUNK-SWA-020, 0.0001.ipt
Mechanik/ATC_Kopfseite/AIS2024/SCHUNK-0302323 SWA-020-000-000, .iam
Mechanik/ATC_Kopfseite/AIS2024/SCHUNK-SWA-020, 0.ipt
Mechanik/Adapter/OldVersions/SCHUNK-0302201 A-SWK-020-ISO-A50.0002.ipt
Mechanik/Adapter/SCHUNK-0302201 A-SWK-020-ISO-A50.ipt
Mechanik/BT2_2_2_Biegeroboter_2.ipt
Mechanik/Biegekopf/188635080-9-gearbox_ab115-100-s2-p2-12/OldVersions/gearbox_ab115-100-s2-p2-12.0003.ipt
Mechanik/Biegekopf/188635080-9-gearbox_ab115-100-s2-p2-12/gearbox_ab115-100-s2-p2-12.ipt
Mechanik/Biegekopf/BG001_bensen22_26_Biegeroboter_biegekopf_gesamt_v1.iam
Mechanik/Biegekopf/BG006_thutrn22_26_Biegeroboter_biegekopf_gesamt_v2.iam
Mechanik/Biegekopf/BT016_thutrn22_26_Biegeroboter_roboter_flansch.ipt
Mechanik/Biegekopf/Biegerolle 62/Biegerolle 62.ipt
Mechanik/Biegekopf/Bolzen/Bolzen/Bolzen.ipt
Mechanik/Biegekopf/Bolzen/Bolzen/OldVersions/Bolzen.0001.ipt
Mechanik/Biegekopf/Deckenkonstruktion/BG004_bensen22_26_Biegeroboter_deckenkonstruktion_gesamt_v1.iam
Mechanik/Biegekopf/Deckenkonstruktion/DIN 1025 - IPBv 240-2343,6.ipt
Mechanik/Biegekopf/Deckenkonstruktion/DIN 1025 - IPBv 260-2343,4.ipt
Mechanik/Biegekopf/Deckenkonstruktion/DIN 1025 - IPE 180-2343,6.ipt
Mechanik/Biegekopf/Deckenkonstruktion/DIN 1025 - IPE 220-2343,4.ipt
Mechanik/Biegekopf/Deckenkonstruktion/DIN 1025 - IPE 270-3000.ipt
Mechanik/Biegekopf/Deckenkonstruktion/OldVersions/BG004_bensen22_26_Biegeroboter_deckenkonstruktion_gesamt_v1.0003.iam
Mechanik/Biegekopf/Gehäuse Display/BT028_thutrn22_26_Biegeroboter_gehaeuse_display.ipt
Mechanik/Biegekopf/Gehäuse Display/OldVersions/BT028_thutrn22_26_Biegeroboter_gehaeuse_display.0001.ipt
Mechanik/Biegekopf/Gehäuse/BG004_thutrn22_26_Biegeroboter_biegekopf_gesamt_allein.iam
Mechanik/Biegekopf/Gehäuse/BG008_bensen22_26_Biegeroboter_gehäuse_verlängerung_v1.iam
Mechanik/Biegekopf/Gehäuse/BG009_thutrn22_26_Biegeroboter_gehaeuse_gesamt_v3.iam
Mechanik/Biegekopf/Gehäuse/BS EN 10056-1 - L25x25x4-70.ipt
Mechanik/Biegekopf/Gehäuse/BS EN 10056-1 - L40x40x5-70.ipt
Mechanik/Biegekopf/Gehäuse/BT001_bensen22_26_Biegeroboter_gehäuse_getriebe_v1.ipt
Mechanik/Biegekopf/Gehäuse/BT002_bensen22_26_Biegeroboter_gehäuse_motor_v1.ipt
Mechanik/Biegekopf/Gehäuse/BT003_bensen22_26_Biegeroboter_gehäuse_motor_deckel_v1.ipt
Mechanik/Biegekopf/Gehäuse/BT006_bensen22_26_Biegeroboter_gehäuse_motor_deckel_v2.ipt
Mechanik/Biegekopf/Gehäuse/BT017_thutrn22_26_Biegeroboter_gehaeuse_motor_v2.ipt
Mechanik/Biegekopf/Gehäuse/BT017_thutrn22_26_Biegeroboter_gehäuse_oben.ipt
Mechanik/Biegekopf/Gehäuse/BT018_thutrn22_26_Biegeroboter_gehaeuse_motor_deckel_v2.ipt
Mechanik/Biegekopf/Gehäuse/BT019_thutrn22_26_Biegeroboter_gehaeuse_getriebe_v2.ipt
Mechanik/Biegekopf/Gehäuse/BT021_thutrn22_26_Biegeroboter_distanzleiste.ipt
Mechanik/Biegekopf/Gehäuse/BT022_thutrn22_26_Biegeroboter_gehaeuse_deckel_motor_v3.ipt
Mechanik/Biegekopf/Gehäuse/BT023_thutrn22_26_Biegeroboter_halterung_getriebe.ipt
Mechanik/Biegekopf/Gehäuse/BT024_thutrn22_26_Biegeroboter_halterung_motor.ipt
Mechanik/Biegekopf/Gehäuse/BT025_thutrn22_26_Biegeroboter_gehaeuse_deckel_getriebe.ipt
Mechanik/Biegekopf/Gehäuse/BT026_thutrn22_26_Biegeroboter_gehaeuse_getriebe_deckel_oben.ipt
Mechanik/Biegekopf/Gehäuse/BT027_thutrn22_26_Biegeroboter_gehaeuse_lasche_deckel.ipt
Mechanik/Biegekopf/Gehäuse/DIN EN 10219-2 - 100 x 100 x 5 - 130.ipt
Mechanik/Biegekopf/Gehäuse/DIN EN 10219-2 - 120 x 120 x 5 - 230.ipt
Mechanik/Biegekopf/Gehäuse/DIN EN 10219-2 - 140 x 140 x 5 - 230.ipt
Mechanik/Biegekopf/Gehäuse/DIN EN 10219-2 - 140 x 140 x 5 - 250.ipt
Mechanik/Biegekopf/Gehäuse/DIN EN 10219-2 - 150 x 150 x 5 - 230.ipt
Mechanik/Biegekopf/Gehäuse/DIN EN 10219-2 - 90 x 90 x 5 - 0,001.ipt
Mechanik/Biegekopf/Gehäuse/OldVersions/BG004_thutrn22_26_Biegeroboter_biegekopf_gesamt_allein.0009.iam
Mechanik/Biegekopf/Gehäuse/OldVersions/BG008_bensen22_26_Biegeroboter_gehäuse_verlängerung_v1.0001.iam
Mechanik/Biegekopf/Gehäuse/OldVersions/BG009_thutrn22_26_Biegeroboter_gehaeuse_gesamt_v3.0029.iam
Mechanik/Biegekopf/Gehäuse/OldVersions/BS EN 10056-1 - L40x40x5-70.0001.ipt
Mechanik/Biegekopf/Gehäuse/OldVersions/BT001_bensen22_26_Biegeroboter_gehäuse_getriebe_v1.0003.ipt
Mechanik/Biegekopf/Gehäuse/OldVersions/BT001_bensen22_26_Biegeroboter_gehäuse_motor_v1.0006.ipt
Mechanik/Biegekopf/Gehäuse/OldVersions/BT002_bensen22_26_Biegeroboter_gehäuse_motor_deckel_v1.0003.ipt
Mechanik/Biegekopf/Gehäuse/OldVersions/BT002_bensen22_26_Biegeroboter_gehäuse_motor_v1.0008.ipt
Mechanik/Biegekopf/Gehäuse/OldVersions/BT006_bensen22_26_Biegeroboter_gehäuse_motor_deckel_v2.0009.ipt
Mechanik/Biegekopf/Gehäuse/OldVersions/BT017_thutrn22_26_Biegeroboter_gehäuse_oben.0004.ipt
Mechanik/Biegekopf/Gehäuse/OldVersions/BT018_thutrn22_26_Biegeroboter_gehaeuse_motor_deckel_v2.0002.ipt
Mechanik/Biegekopf/Gehäuse/OldVersions/BT021_thutrn22_26_Biegeroboter_distanzleiste.0013.ipt
Mechanik/Biegekopf/Gehäuse/OldVersions/BT022_thutrn22_26_Biegeroboter_gehaeuse_deckel_motor_v3.0005.ipt
Mechanik/Biegekopf/Gehäuse/OldVersions/BT023_thutrn22_26_Biegeroboter_halterung_getriebe.0010.ipt
Mechanik/Biegekopf/Gehäuse/OldVersions/BT024_thutrn22_26_Biegeroboter_halterung_motor.0005.ipt
Mechanik/Biegekopf/Gehäuse/OldVersions/BT025_thutrn22_26_Biegeroboter_gehaeuse_deckel_getriebe.0006.ipt
Mechanik/Biegekopf/Gehäuse/OldVersions/BT026_thutrn22_26_Biegeroboter_gehaeuse_getriebe_deckel_oben.0011.ipt
Mechanik/Biegekopf/Gehäuse/OldVersions/BT027_thutrn22_26_Biegeroboter_gehaeuse_lasche_deckel.0002.ipt
Mechanik/Biegekopf/Gehäuse/OldVersions/DIN EN 10219-2 - 100 x 100 x 5 - 130.0014.ipt
Mechanik/Biegekopf/Gehäuse/OldVersions/DIN EN 10219-2 - 120 x 120 x 5 - 230.0001.ipt
Mechanik/Biegekopf/Gehäuse/OldVersions/DIN EN 10219-2 - 140 x 140 x 5 - 230.0001.ipt
Mechanik/Biegekopf/Gehäuse/OldVersions/DIN EN 10219-2 - 150 x 150 x 5 - 230.0019.ipt
Mechanik/Biegekopf/Gehäuse/OldVersions/DIN EN 10219-2 - 90 x 90 x 5 - 0,001.0002.ipt
Mechanik/Biegekopf/Gesamte Baugruppen/BG007_thutrn22_26_Biegeroboter_gesamt_v2.iam
Mechanik/Biegekopf/Gesamte Baugruppen/BT015_thutrn22_26_Biegeroboter_Tisch.ipt
Mechanik/Biegekopf/Gesamte Baugruppen/OldVersions/BG007_thutrn22_26_Biegeroboter_gesamt_v2.0007.iam
Mechanik/Biegekopf/Gesamte Baugruppen/OldVersions/BT015_thutrn22_26_Biegeroboter_Tisch.0003.ipt
Mechanik/Biegekopf/Hantelrolle/Hantelrolle.ipt
Mechanik/Biegekopf/MATSUSHITA_MSMF082L1U1/AIS2024/MSME082G1U_key.ipt
Mechanik/Biegekopf/MATSUSHITA_MSMF082L1U1/AIS2024/MSME082G1U_msmf_gh.ipt
Mechanik/Biegekopf/MATSUSHITA_MSMF082L1U1/AIS2024/MSMF082L1U1.iam
Mechanik/Biegekopf/MATSUSHITA_MSMF082L1U1/AIS2024/OldVersions/MSME082G1U_key.0001.ipt
Mechanik/Biegekopf/MATSUSHITA_MSMF082L1U1/AIS2024/OldVersions/MSME082G1U_msmf_gh.0002.ipt
Mechanik/Biegekopf/MATSUSHITA_MSMF082L1U1/AIS2024/OldVersions/MSMF082L1U1.0003.iam
Mechanik/Biegekopf/OldVersions/BG001_bensen22_26_Biegeroboter_biegekopf_gesamt_v1.0011.iam
Mechanik/Biegekopf/OldVersions/BG001_bensen22_26_Biegeroboter_biegekopf_gesamt_v1.0012.iam
Mechanik/Biegekopf/OldVersions/BG004_thutrn22_26_Biegeroboter_biegekopf_gesamt_allein.0003.iam
Mechanik/Biegekopf/OldVersions/BG006_thutrn22_26_Biegeroboter_biegekopf_gesamt_v2.0002.iam
Mechanik/Biegekopf/OldVersions/BT016_thutrn22_26_Biegeroboter_roboter_flansch.0002.ipt
Mechanik/Biegekopf/Verlängerung/BG002_bensen22_26_Biegeroboter_verlängerung_gesamt_v1.iam
Mechanik/Biegekopf/Verlängerung/BG003_thutrn22_26_Biegeroboter_verlängerung_gesamt_v2.iam
Mechanik/Biegekopf/Verlängerung/BT007_bensen22_26_Biegeroboter_verlängerung_aufnahme_v1.ipt
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
