thurnertristan/diplomarbeit_dateien/Mechanik/FairinoF20_Dateien/Biegeroboter_gesamt.pdf

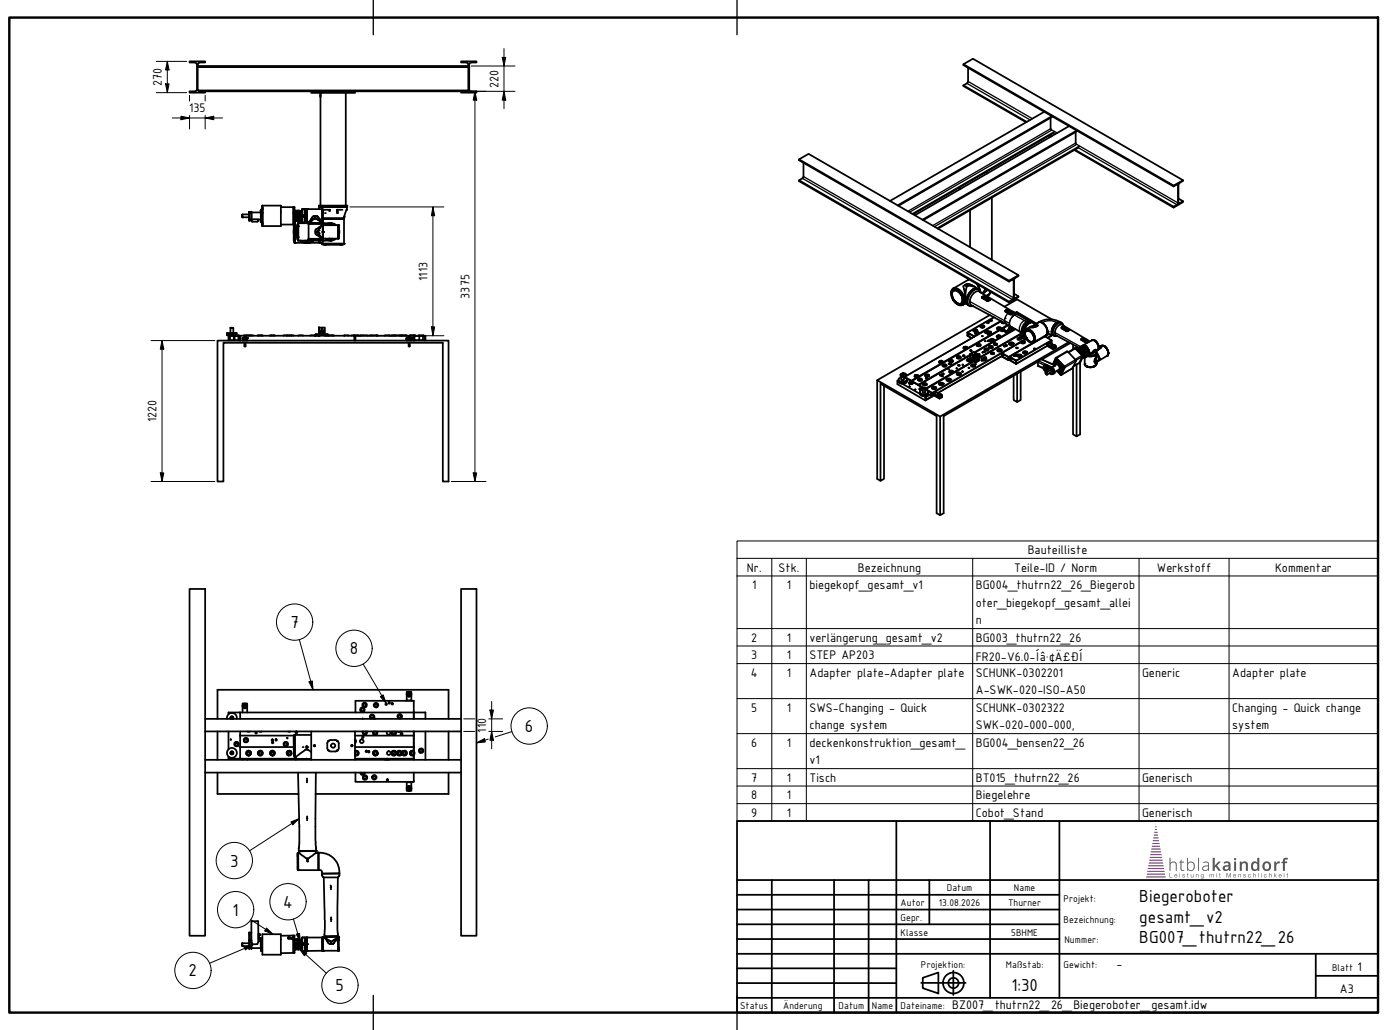
[picture p33: page 1]
Stk.; Bezeichnung; Teile-ID / Norm; Werkstoff; Kommentar; STEP AP203; SCHUNK-0302201; Generic; Adapter plate; Adapter plate-Adapter plate; SWS-Changing - Quick; change system; deckenkonstruktion_gesamt_ BG004_bensen22_26; Status; Änderung; Datum Name; Blatt 1; gesamt_ v2 BG007_ thutrn22_ 26

Changing - Quick change
system

Dateiname: BZ007_ thutrn22_ 26_ Biegeroboter_ gesamt.idw
