thurnertristan/diplomarbeit_dateien/Mechanik/FairinoF20_Dateien/Biegeroboter_Biegeleere.pdf

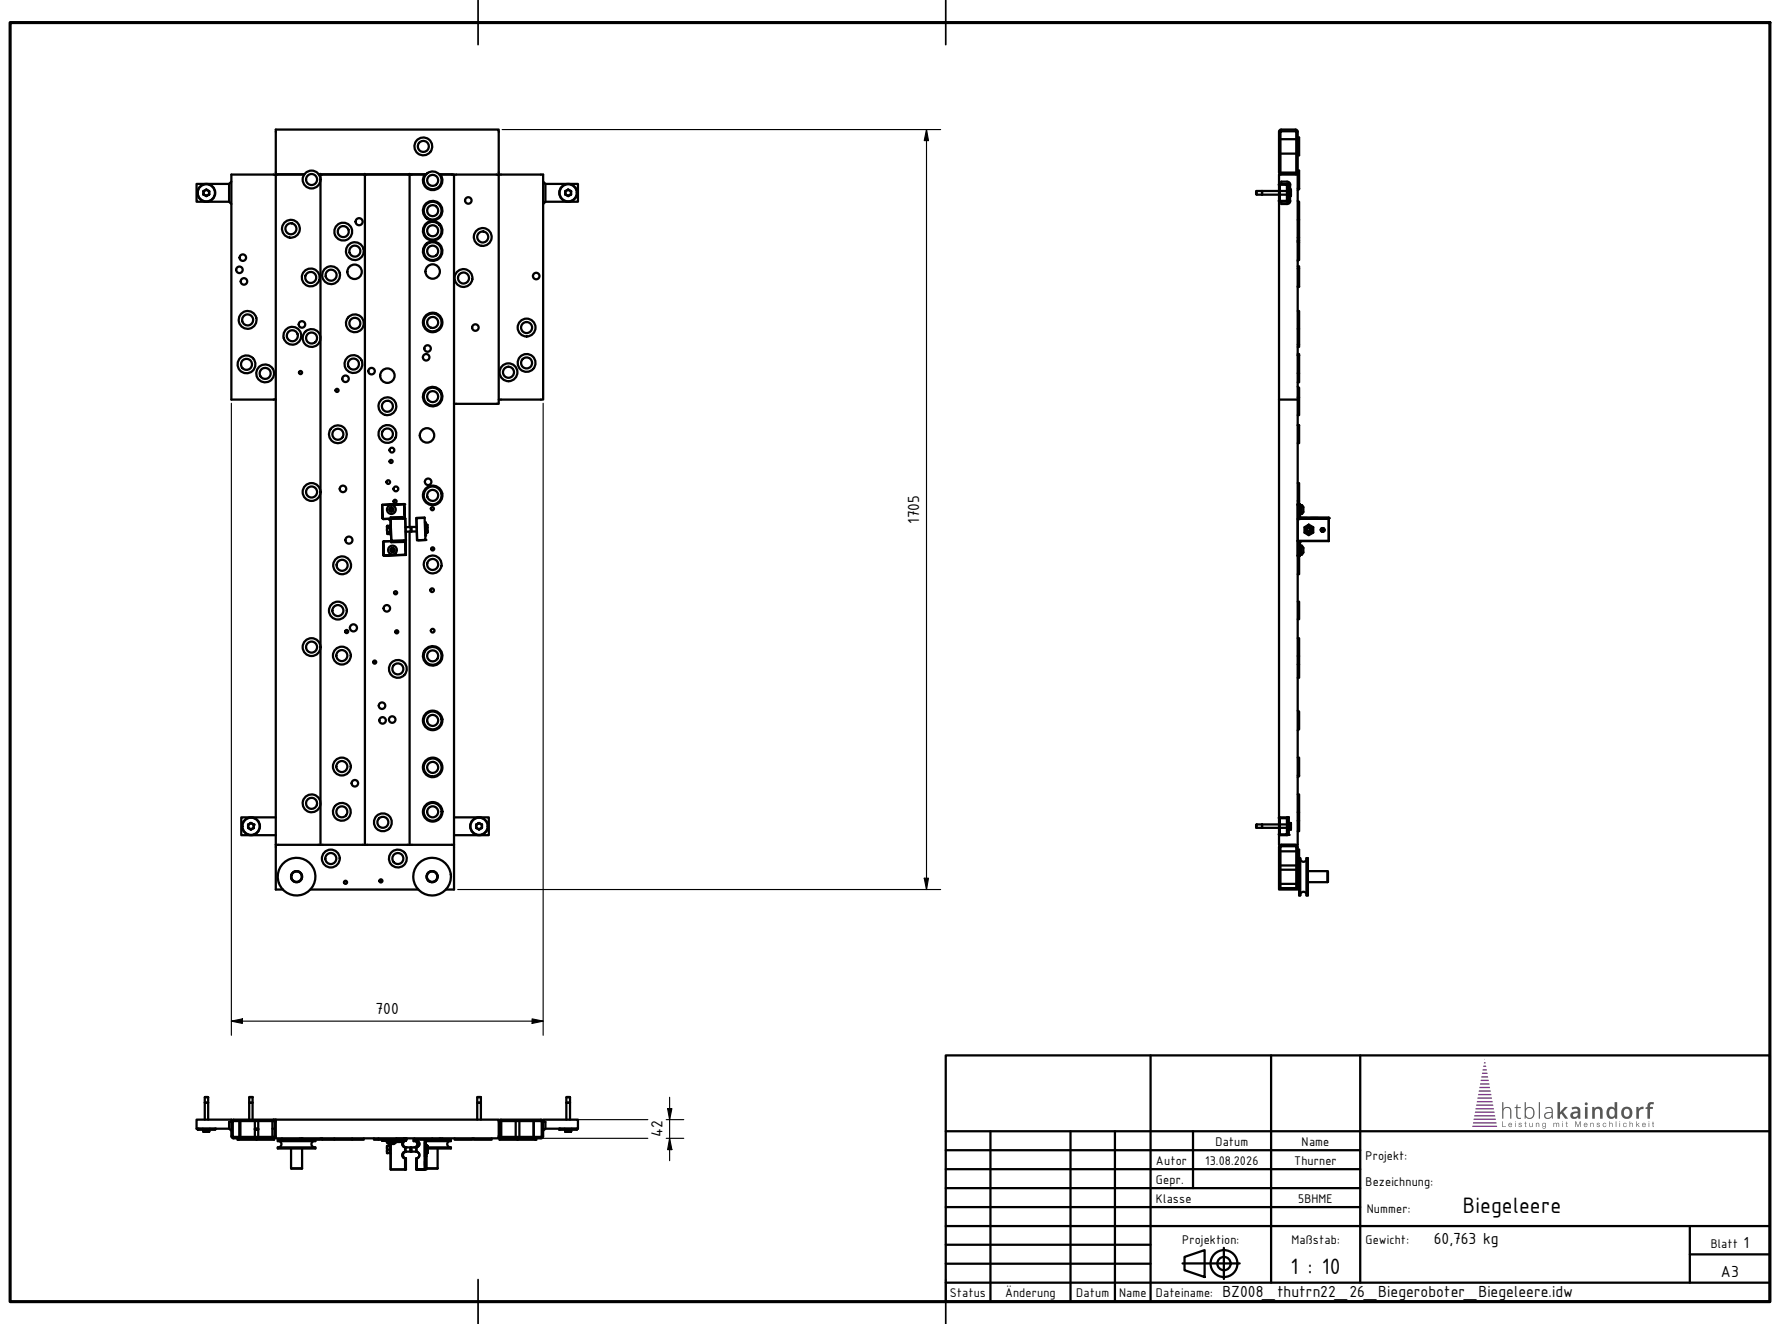
[picture p34: page 1]
Blatt 1

Datum | Name | Projekt: Bezeichnung: Biegeleere Nummer:

Autor | 13.08.2026 | Thurner
Gepr.
Klasse | | 5BHME

Dateiname: BZ008_ thutrn22_ 26_ Biegeroboter_ Biegeleere.idw
