thurnertristan/diplomarbeit_dateien/Mechanik/FairinoF20_Dateien/Biegeroboter_gehäuse.pdf

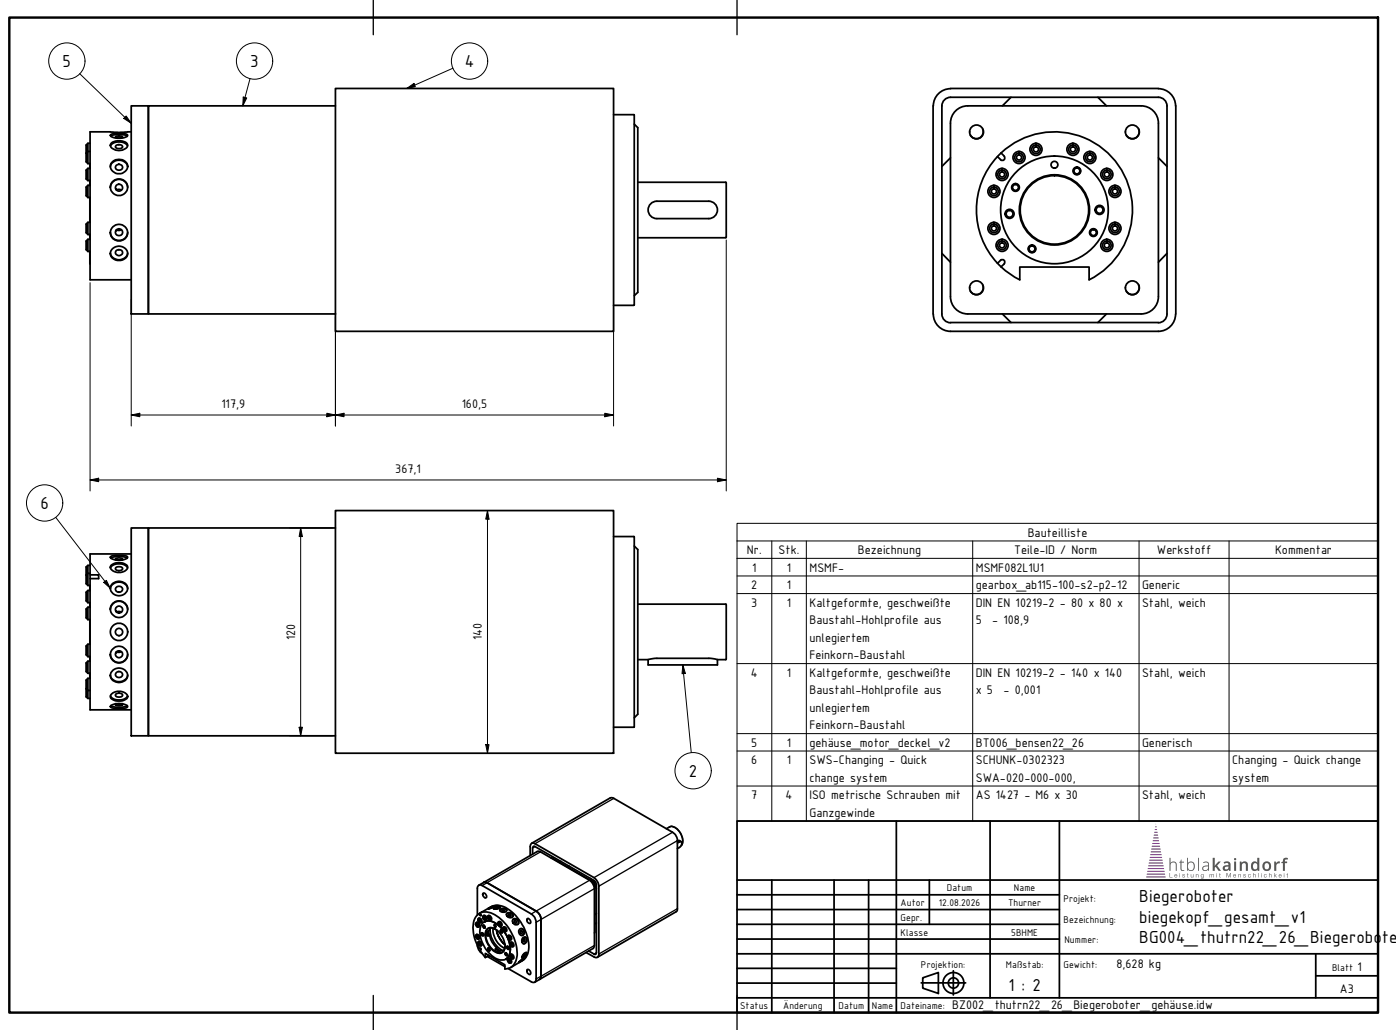
[picture p35: page 1]
Blatt 1; BG004_ thutrn22_ 26_ Biegerobote

Nr. | Stk. | Bezeichnung | Teile-ID / Norm | Werkstoff | Kommentar
1 | 1 | MSMF- | MSMF082L1U1
2 | 1 | | gearbox_ab115-100-s2-p2-12 | Generic
3 | 1 | Kaltgeformte, geschweißte Baustahl-Hohlprofile aus unlegiertem Feinkorn-Baustahl | DIN EN 10219-2 - 80 x 80 x 5 - 108,9 | Stahl, weich

4 | 1 | Kaltgeformte, geschweißte Baustahl-Hohlprofile aus unlegiertem Feinkorn-Baustahl | DIN EN 10219-2 - 140 x 140 x 5 - 0,001 | Stahl, weich

5 | 1 | gehäuse_motor_deckel_v2 | BT006_bensen22_26 | Generisch
6 | 1 | SWS-Changing - Quick change system | SCHUNK-0302323 SWA-020-000-000, | | Changing - Quick change system

7 | 4 | ISO metrische Schrauben mit Ganzgewinde | AS 1427 - M6 x 30 | Stahl, weich

Datum | Name | Biegeroboter Projekt: biegekopf_ gesamt_ v1 Bezeichnung: Nummer:

Autor | 12.08.2026 | Thurner
Gepr.
Klasse | | 5BHME

Dateiname: BZ002_ thutrn22_ 26_ Biegeroboter_ gehäuse.idw
