thurnertristan/diplomarbeit_dateien/Mechanik/FairinoF20_Dateien/Biegeroboter_verlängerung.pdf

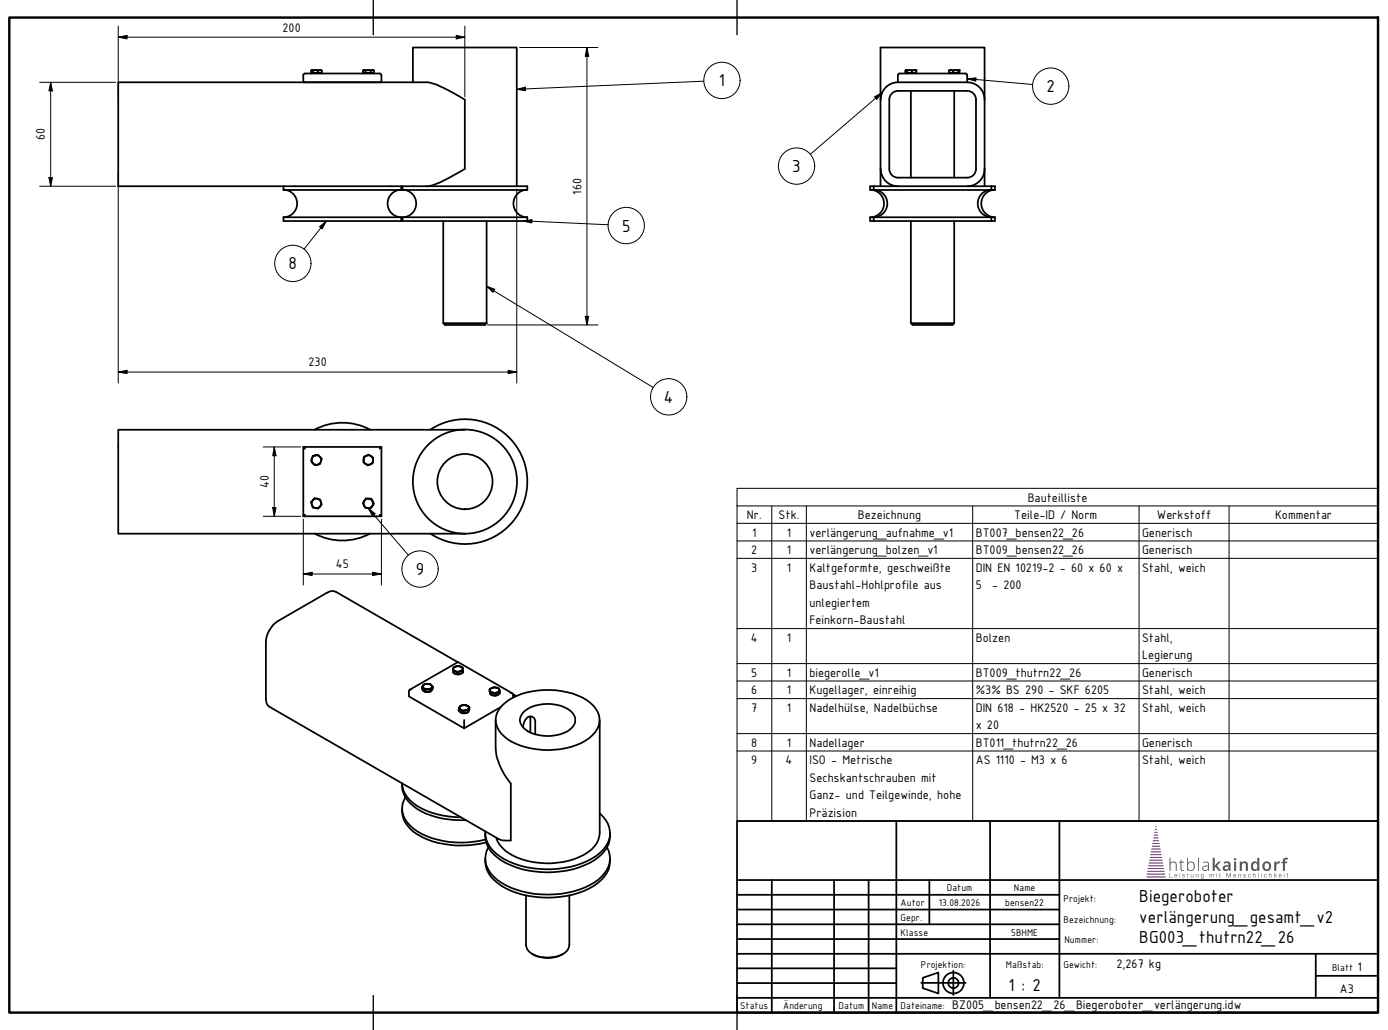
[picture p36: page 1]
Blatt 1

Nr. | Stk. | Bezeichnung | Teile-ID / Norm | Werkstoff | Kommentar
1 | 1 | verlängerung_aufnahme_v1 | BT007_bensen22_26 | Generisch
2 | 1 | verlängerung_bolzen_v1 | BT009_bensen22_26 | Generisch
3 | 1 | Kaltgeformte, geschweißte Baustahl-Hohlprofile aus unlegiertem Feinkorn-Baustahl | DIN EN 10219-2 - 60 x 60 x 5 - 200 | Stahl, weich

4 | 1 | | Bolzen | Stahl, Legierung

5 | 1 | biegerolle_v1 | BT009_thutrn22_26 | Generisch
6 | 1 | Kugellager, einreihig | %3% BS 290 - SKF 6205 | Stahl, weich
7 | 1 | Nadelhülse, Nadelbüchse | DIN 618 - HK2520 - 25 x 32 x 20 | Stahl, weich

8 | 1 | Nadellager | BT011_thutrn22_26 | Generisch
9 | 4 | ISO - Metrische Sechskantschrauben mit Ganz- und Teilgewinde, hohe Präzision | AS 1110 - M3 x 6 | Stahl, weich

Datum | Name | Biegeroboter Projekt: verlängerung_ gesamt_ v2 Bezeichnung: BG003_ thutrn22_ 26 Nummer:

Autor | 13.08.2026 | bensen22
Gepr.
Klasse | | 5BHME

Dateiname: BZ005_ bensen22_ 26_ Biegeroboter_ verlängerung.idw
