thurnertristan/diplomarbeit_dateien/Mechanik/Biegekopf/Gehaeuse_gesamt/BZ004_thutrn22_26_Biegeroboter_gehaeuse_gesamt.pdf

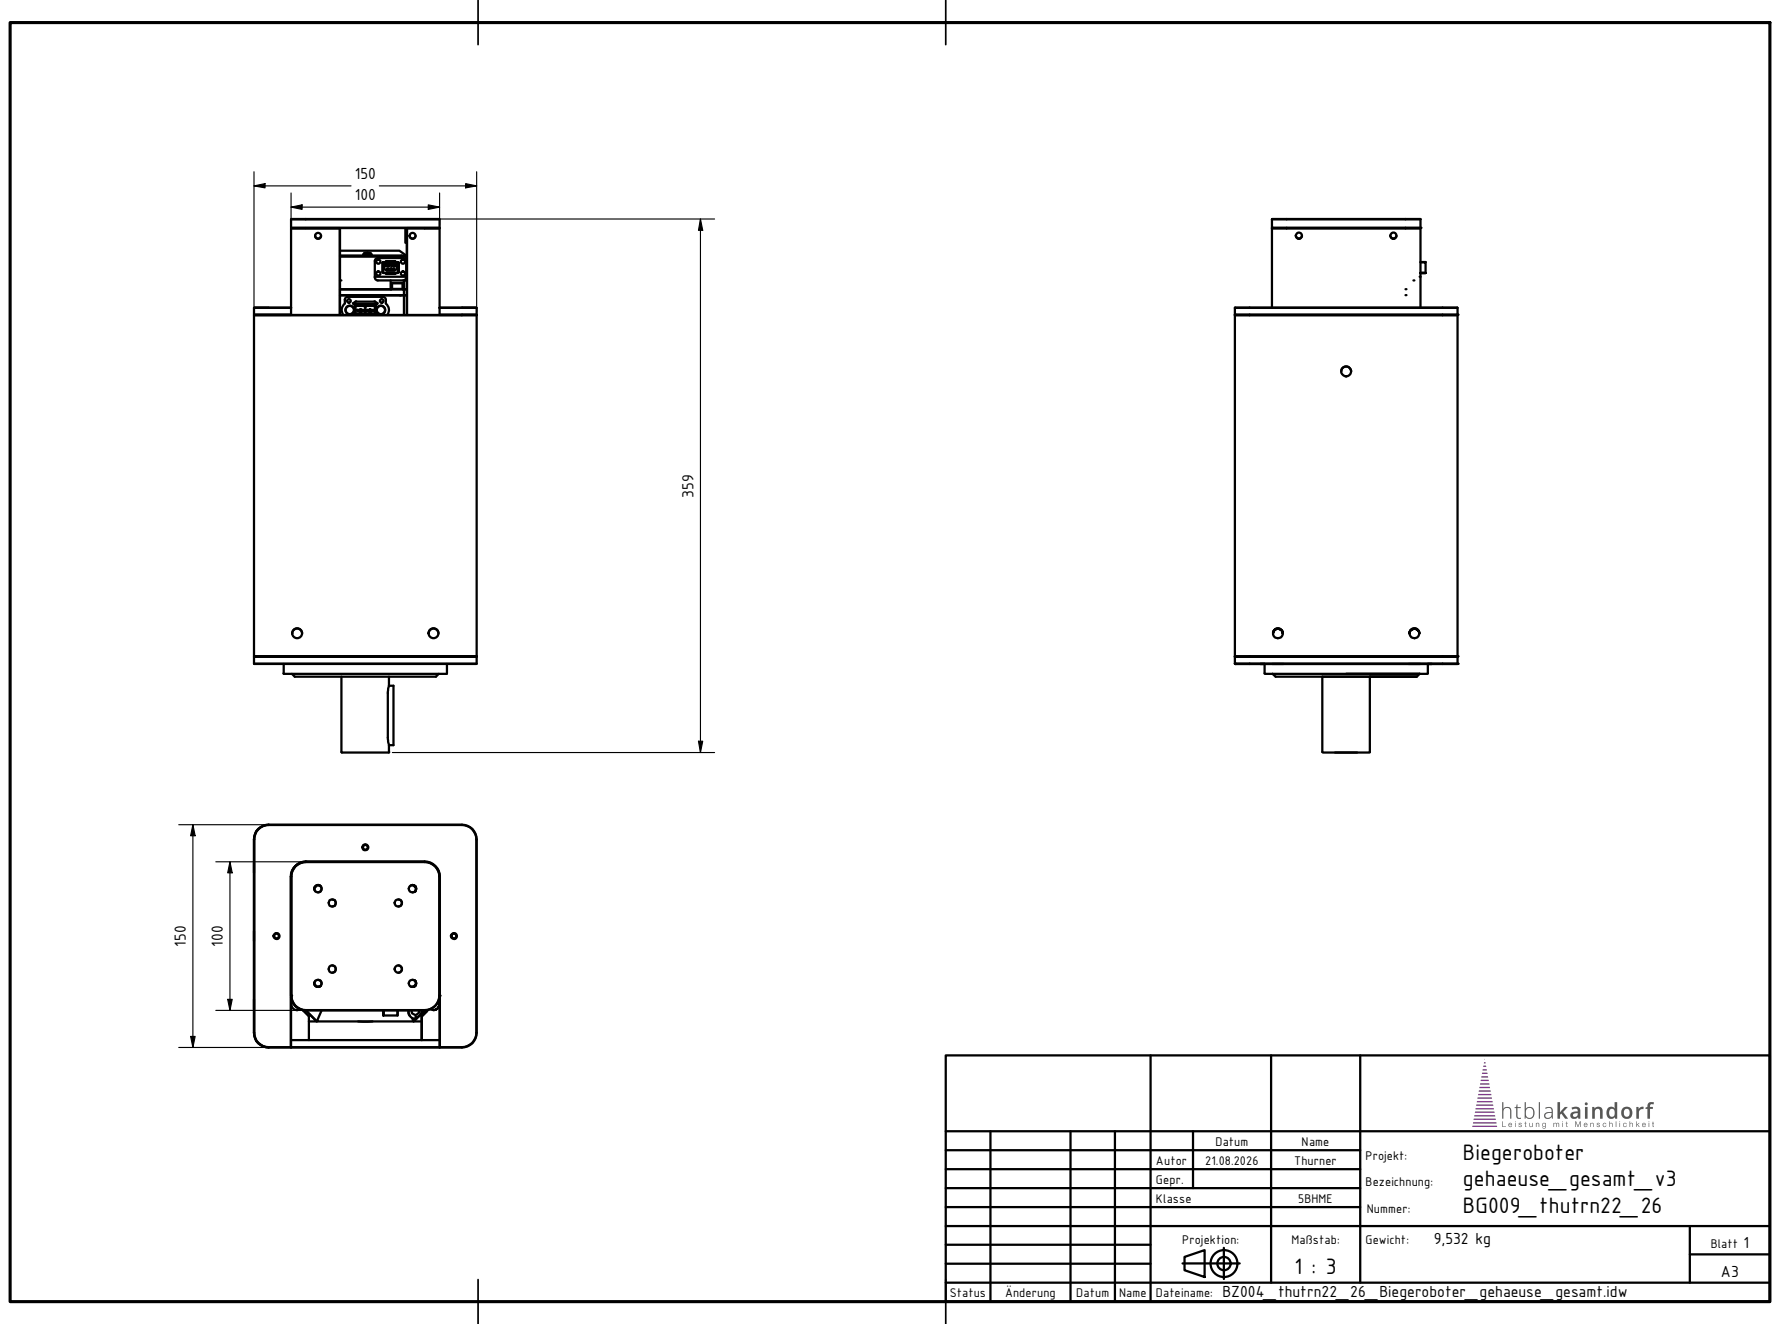
[picture p37: page 1]
Blatt 1

Datum | Name | Biegeroboter Projekt: gehaeuse_ gesamt_ v3 Bezeichnung: BG009_ thutrn22_ 26 Nummer:

Autor | 21.08.2026 | Thurner
Gepr.
Klasse | | 5BHME

Dateiname: BZ004_ thutrn22_ 26_ Biegeroboter_ gehaeuse_ gesamt.idw
