thurnertristan/diplomarbeit_dateien/(commit log)

2026-08-03 BiegelehreCAD und Roboterarmauswahl
    [AS 1110 - M6 x 20.ipt, Anschweißlasche Scheibe.ipt, Anschweißlasche Schraube M8.ipt, Anschweißlasche.iam, Anschweißlasche.ipt, BS 290 SKF - SKF 6205.ipt, BS 290 SKF - SKF 6304.ipt, Baugruppe1.0007.iam]
2026-08-10 Biegekopf Konstruktion 1
    [AS 1110 - M6 x 20.ipt, Anschweißlasche Scheibe.ipt, Anschweißlasche Schraube M8.ipt, Anschweißlasche.iam, Anschweißlasche.ipt, BG001_bensen22_26_Biegeroboter_biegekopf_gesamt_v1.0006.iam, BG001_bensen22_26_Biegeroboter_biegekopf_gesamt_v1.iam, BS 290 SKF - SKF 6205.ipt]
2026-08-10 Biegekopf Konstruktion 2
    [BG001_bensen22_26_Biegeroboter_biegekopf_gesamt_v1.0006.iam, BG001_bensen22_26_Biegeroboter_biegekopf_gesamt_v1.0010.iam, BG001_bensen22_26_Biegeroboter_biegekopf_gesamt_v1.iam, BG002_bensen22_26_Biegeroboter_verlängerung_gesamt_v1.0004.iam, BG002_bensen22_26_Biegeroboter_verlängerung_gesamt_v1.iam, BT004_bensen22_26_Biegeroboter_verlängerung_v1.ipt, BT005_bensen22_26_Biegeroboter_verlängerung_st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]
2026-08-13 V2 der Roboter verlängerung
    [BG001_bensen22_26_Biegeroboter_biegekopf_gesamt_v1.0010.iam, BG001_bensen22_26_Biegeroboter_biegekopf_gesamt_v1.0012.iam, BG001_bensen22_26_Biegeroboter_biegekopf_gesamt_v1.iam, BG002_bensen22_26_Biegeroboter_verlängerung_gesamt_v1.0004.iam, BG002_bensen22_26_Biegeroboter_verlängerung_gesamt_v1.0007.iam, BG002_bensen22_26_Biegeroboter_verlängerung_gesamt_v1.iam, BG003_thutrn22_26_Biegeroboter_ver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]
2026-08-13 Biegelehre Step
    [Biegelehre.stp]
2026-08-13 Zeichnungen Gehäuse
    [BG003_thutrn22_26_Biegeroboter_verlängerung_gesamt_v2.0005.iam, BG003_thutrn22_26_Biegeroboter_verlängerung_gesamt_v2.0008.iam, BG003_thutrn22_26_Biegeroboter_verlängerung_gesamt_v2.iam, BG004_thutrn22_26_Biegeroboter_biegekopf_gesamt_allein.0005.iam, BG004_thutrn22_26_Biegeroboter_biegekopf_gesamt_allein.0008.iam, BG004_thutrn22_26_Biegeroboter_biegekopf_gesamt_allein.iam, BG008_bensen22_26_Bieg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]
2026-08-17 neue versionen der Konstruktionen
    [BG003_thutrn22_26_Biegeroboter_verlängerung_gesamt_v2.0005.iam, BG003_thutrn22_26_Biegeroboter_verlängerung_gesamt_v2.0006.iam, BG003_thutrn22_26_Biegeroboter_verlängerung_gesamt_v2.iam, BG004_thutrn22_26_Biegeroboter_biegekopf_gesamt_allein.0006.iam, BG004_thutrn22_26_Biegeroboter_biegekopf_gesamt_allein.0008.iam, BG004_thutrn22_26_Biegeroboter_biegekopf_gesamt_allein.iam, BG007_thutrn22_26_Bieg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]
2026-10-08 Mathcad und Inventor Verbesserungen
    [Anzahl.xlsx, BG003_thutrn22_26_Biegeroboter_verlängerung_gesamt_v2.0006.iam, BG003_thutrn22_26_Biegeroboter_verlängerung_gesamt_v2.0008.iam, BG003_thutrn22_26_Biegeroboter_verlängerung_gesamt_v2.0011.iam, BG003_thutrn22_26_Biegeroboter_verlängerung_gesamt_v2.iam, BG003_thutrn22_26_Biegeroboter_verlängerung_gesamt_v2.stp, BG004_thutrn22_26_Biegeroboter_biegekopf_gesamt_allein.0008.iam, BG004_thutr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]
