thurnertristan/diplomarbeit_dateien/(notices)

Notices in the files:
Mechanik/PARTserver0202608120914509970315710e898ce/SCHUNK-0302323 SWA-020-000-000_ .stp:
author */ ('License CC BY-ND 4.0'),
